les4675/CubeSatTimeCard/Documentation/Phase 1/Use Cases.pdf

Prompt:
Write at least one complete use case - divide up amongst team members so that each student completes a different one.

Rubric:

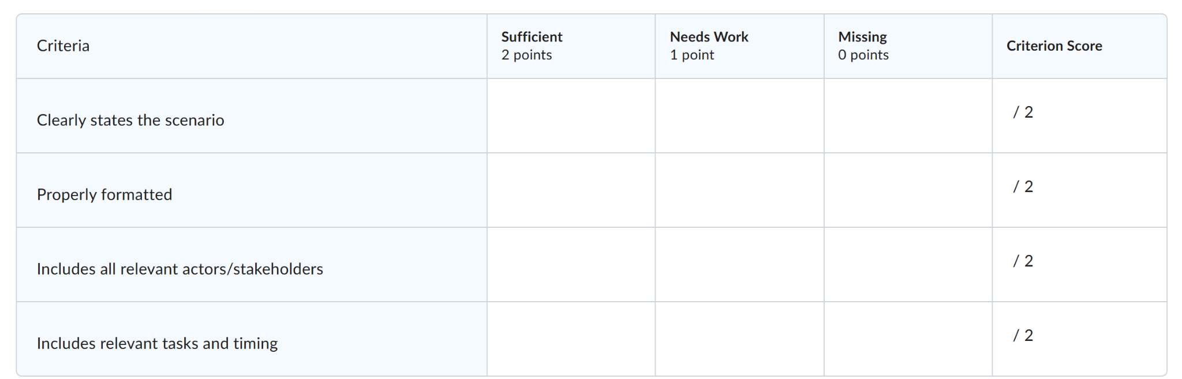
[picture p18: figure]

Use Cases:
1. Atomic clock used to track takeoff of Blue Origin rocket with astronauts
2. Atomic clock used to calculate the position and trajectory of a SpaceX rocket in deep space
3. Atomic clock used for error checking diagnostics of the cubesat
4. Atomic clock used to record precise timestamp for data collection
5. Atomic clock used to allow for proper communication between different channels (baud rate)
6. Atomic clock used for experiments that require precise timing
7. Atomic clock used for time-based encryption between cubesat and ground communications.

Use Case #1:

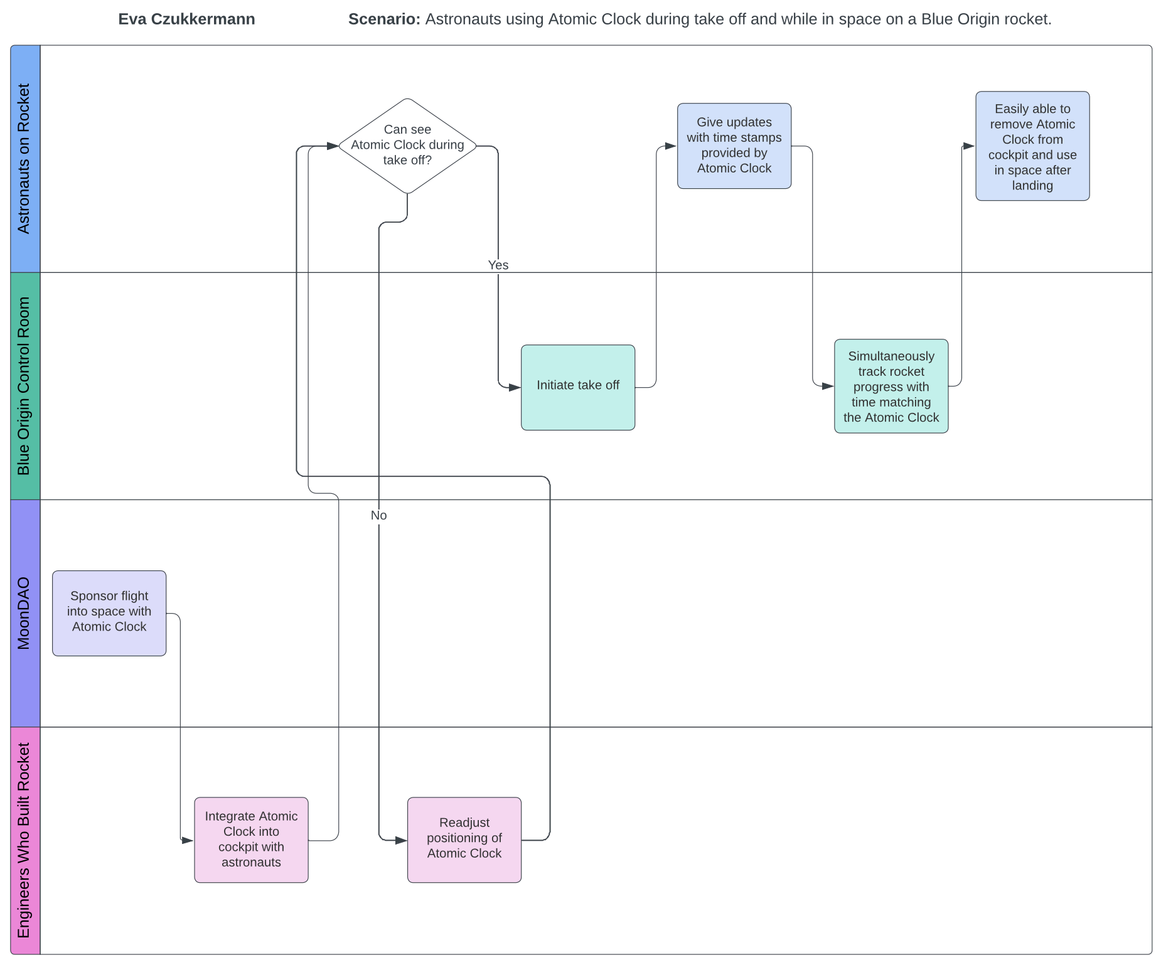
[picture p19: figure]

Use Case #2

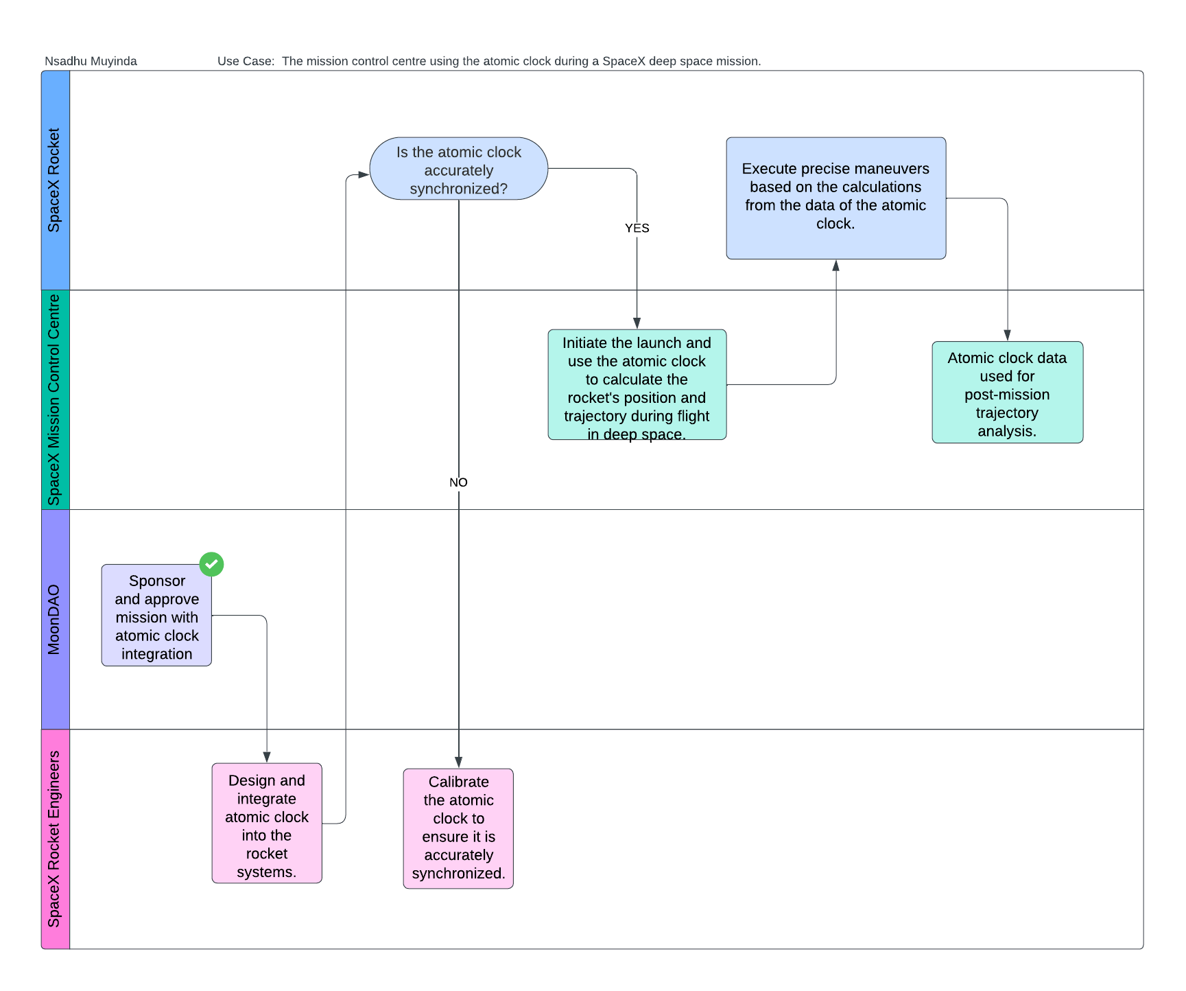
[picture p20: figure]

Use Case 3:

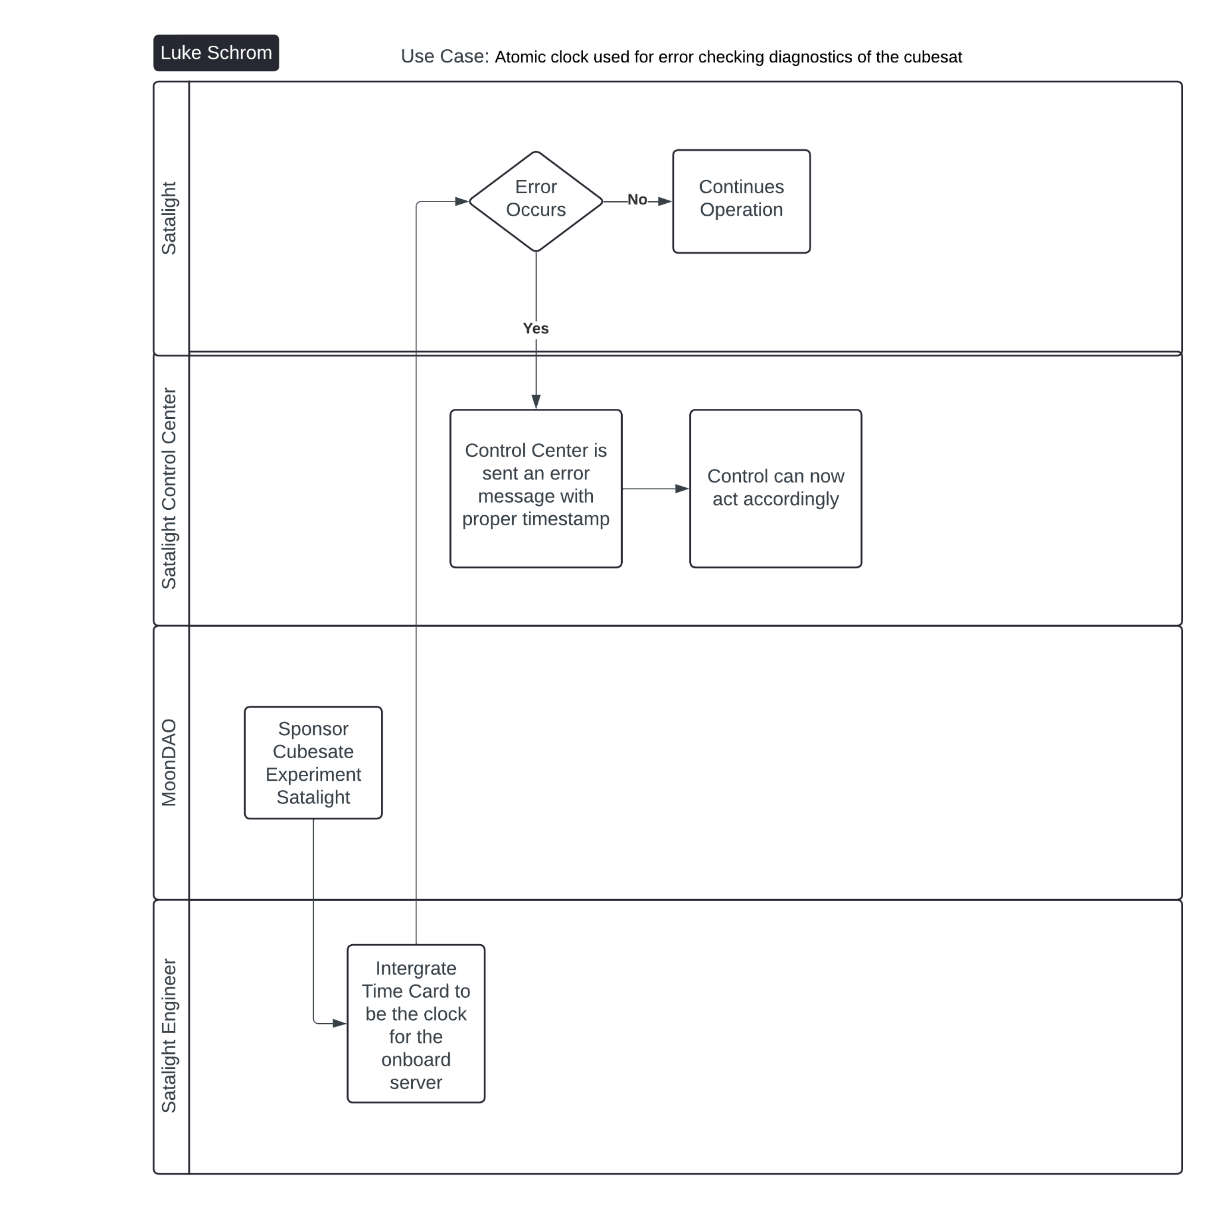
[picture p21: figure]

Use Case 4:

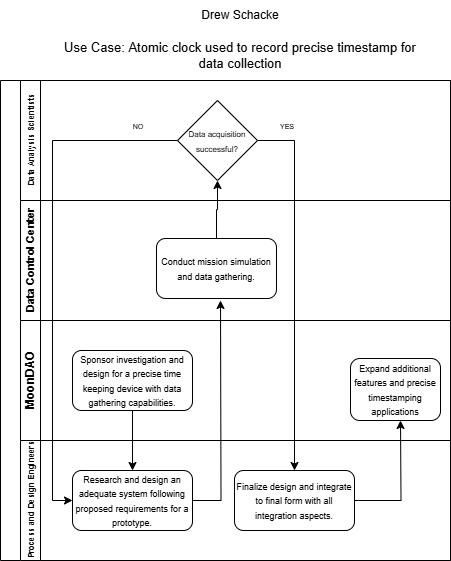
[picture p22: figure]

U

s

e

C

a

s

e

7: A

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
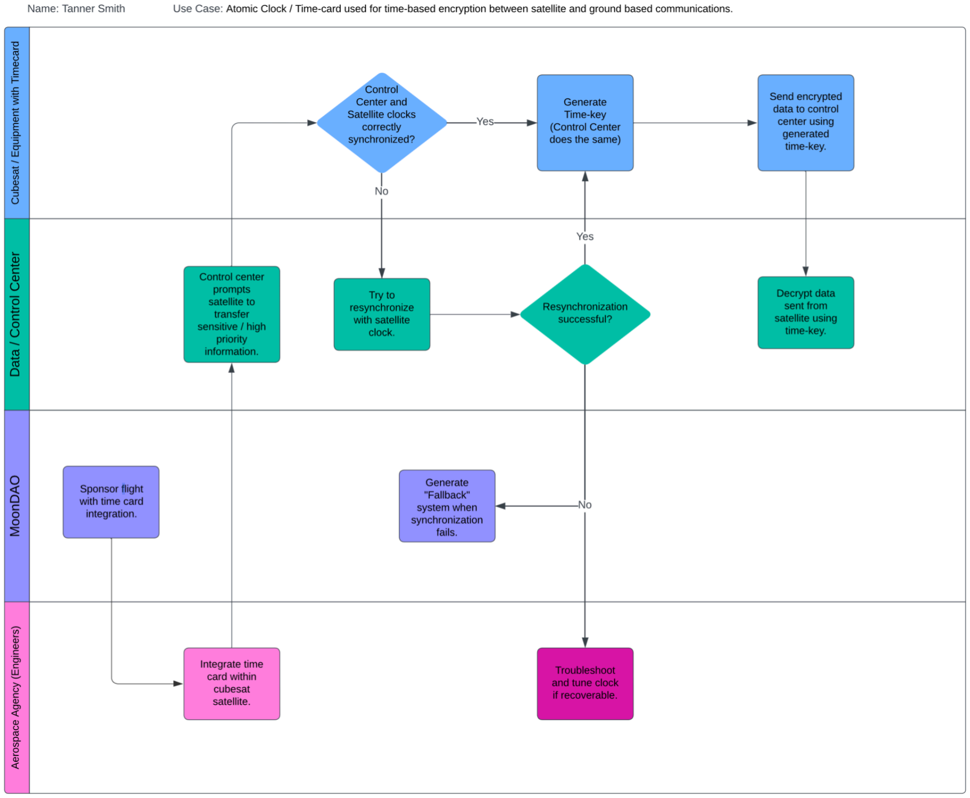
[picture p23: figure]
