les4675/CubeSatTimeCard/Documentation/Phase 4/GNSS Raspberry Pi Server.pdf

Goal: Have a raspberry pi emulate a server that takes in a signal from a GNSS receiver and then relays that information to the time card.
Required materials:
Raspberry Pi: ie pi 5
Receiver:
https://www.digikey.com/en/products/detail/sparkfun-electronics/GPS-18037/16719314

Antenna: https://www.digikey.com/en/products/detail/sparkfun-electronics/GPS-14986/9682235

https://lucid.app/lucidchart/01e8cf91-477b-4eed-92a1-fcaabd95895d/edit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 (https://lucid.app/lucidchart/01e8cf91-477b-4eed-92a1-fcaabd95895d/edit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) Galileo 1575.42 MHz
https://novatel.com/support/known-solutions/gnss-frequencies-and-signals


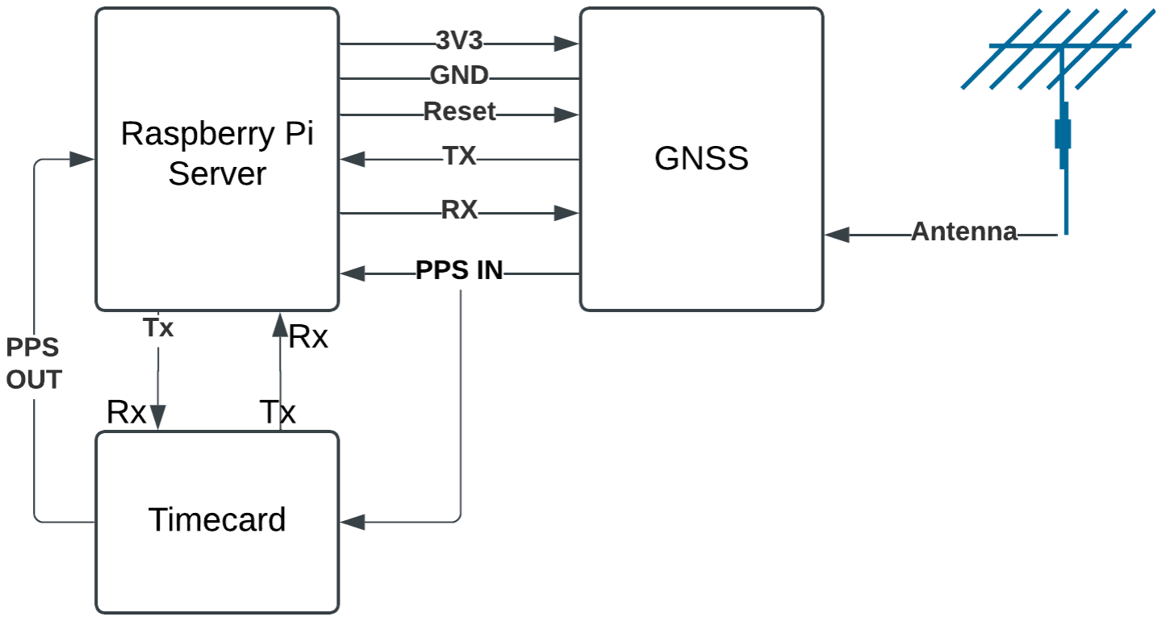
[picture p24: figure]

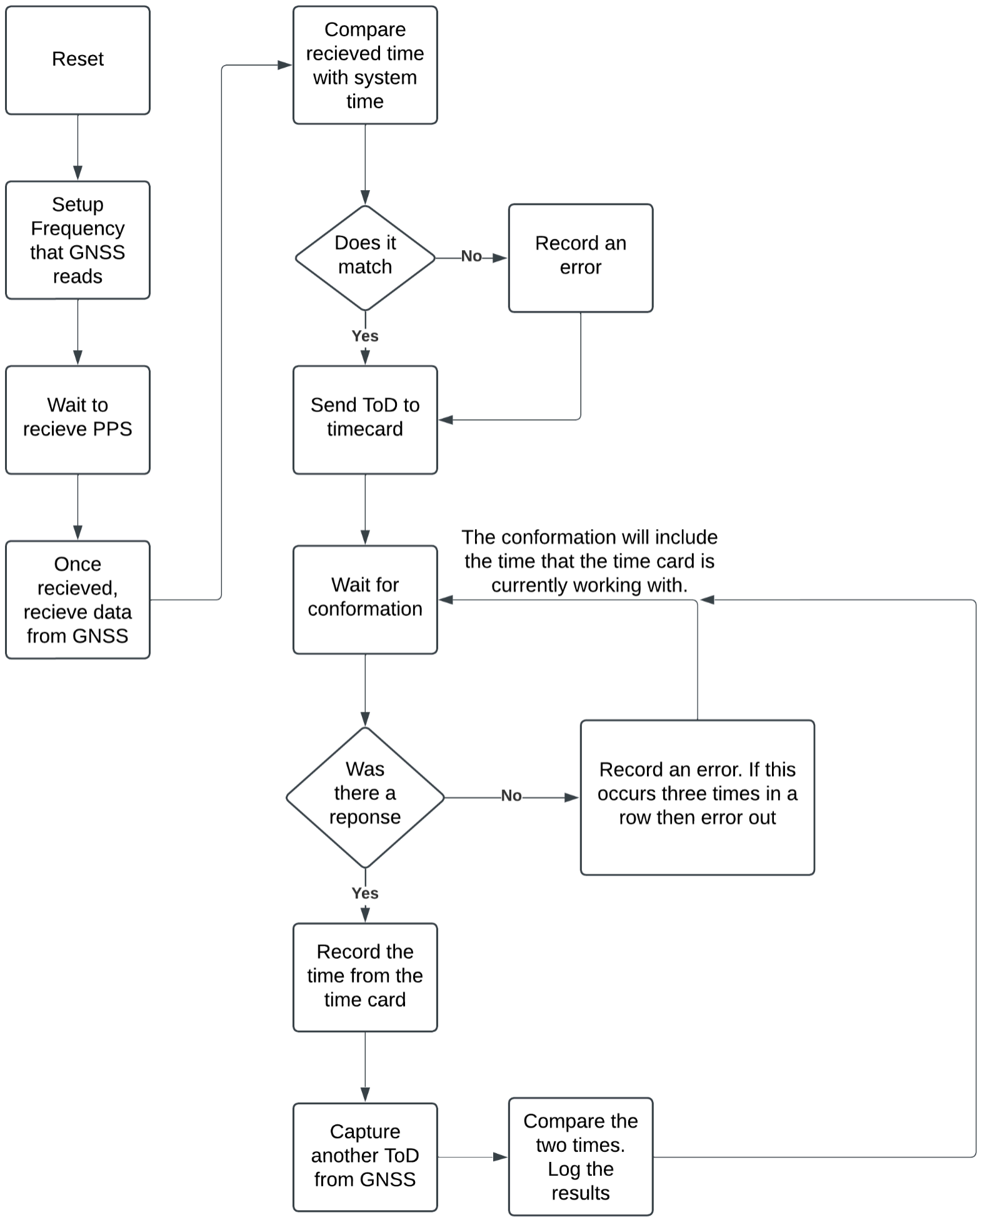
[picture p25: figure]
