les4675/CubeSatTimeCard/Documentation/Phase 3/Copy of Preliminary Detailed Design Phase Summary Report_Reference.docx.pdf

22257: Space Time Card

## Preliminary Detailed Design: Phase-End Summary

This document should continue to document your journey through MSD, so include work-in-progress as well as latest results – this document can be edited live online. Any time you post a snapshot of a document for a phase review, be sure you have a live document to back it up. Your file repository should still contain original editable files, not just .pdf files.

Use the Phase 3 folder to store information supporting this document. Some templates are available in this folder for your use.

Remove all template text from this page prior to your Week 10/11 Preliminary Detailed Level Design Review.

Individual and Team Vision for Preliminary Detailed Design Phase [Tanner]
- What did your team plan to do during this phase?
- What did your team actually accomplish during this phase?
- Since this phase will require students to do more independent work, your team should also capture a summary of key tasks completed, and who was responsible.

**Team plan for this phase:
We planned to start preliminary prototyping in order to prove functionality of our proposed solution that we presented previously. This includes revising component selections, development of a BOM, proposing development kits, testbenches, and ordering long lead time items.

** Accomplished during this phase:
We started producing the preliminary BOM, researching the functionality of the timecard through MATLAB, researching hold over drift characteristics of proposed CSAC and inserting other clocks, as well as inserting ordered items here.

Feasibility: Analysis, Simulations [Team]
Goals
- Justify that the design decisions you are making will result in an acceptable solution.

Instructions
1. Complete various analysis and simulation exercises, especially of critical subsystems. This could include ballpark estimates, and first order analysis.
2. Identify system "transfer function" based inputs, outputs, and key design parameters. This can be done via theoretical analysis or empirical prototyping. It's often helpful to work with multiple members to make sure each subsystem is accurate.
3. Using all of your analyses and models, determine values of all quantitative design parameters. These could be specific values and/or acceptable ranges.

Revised August 2024

4. Confirm that the selected concepts and design plans will be able to achieve the desired performance of your system. Also anticipate any potential failure modes associated with your chosen concepts.

Required Artifacts
- Document listing your quantitative Design Parameters, including quantitative targets and acceptable tolerances.
- Evidence of your feasibility work, including write ups of any theoretical analysis, and/or photos and videos of your simulations
- Summarize what you learned for each feasibility activity, and what decisions were made as a result.

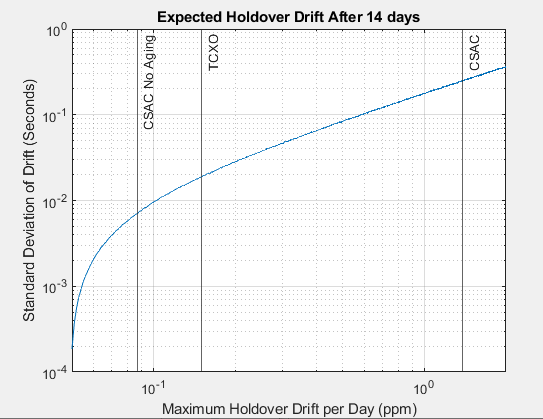
[picture p33: figure]
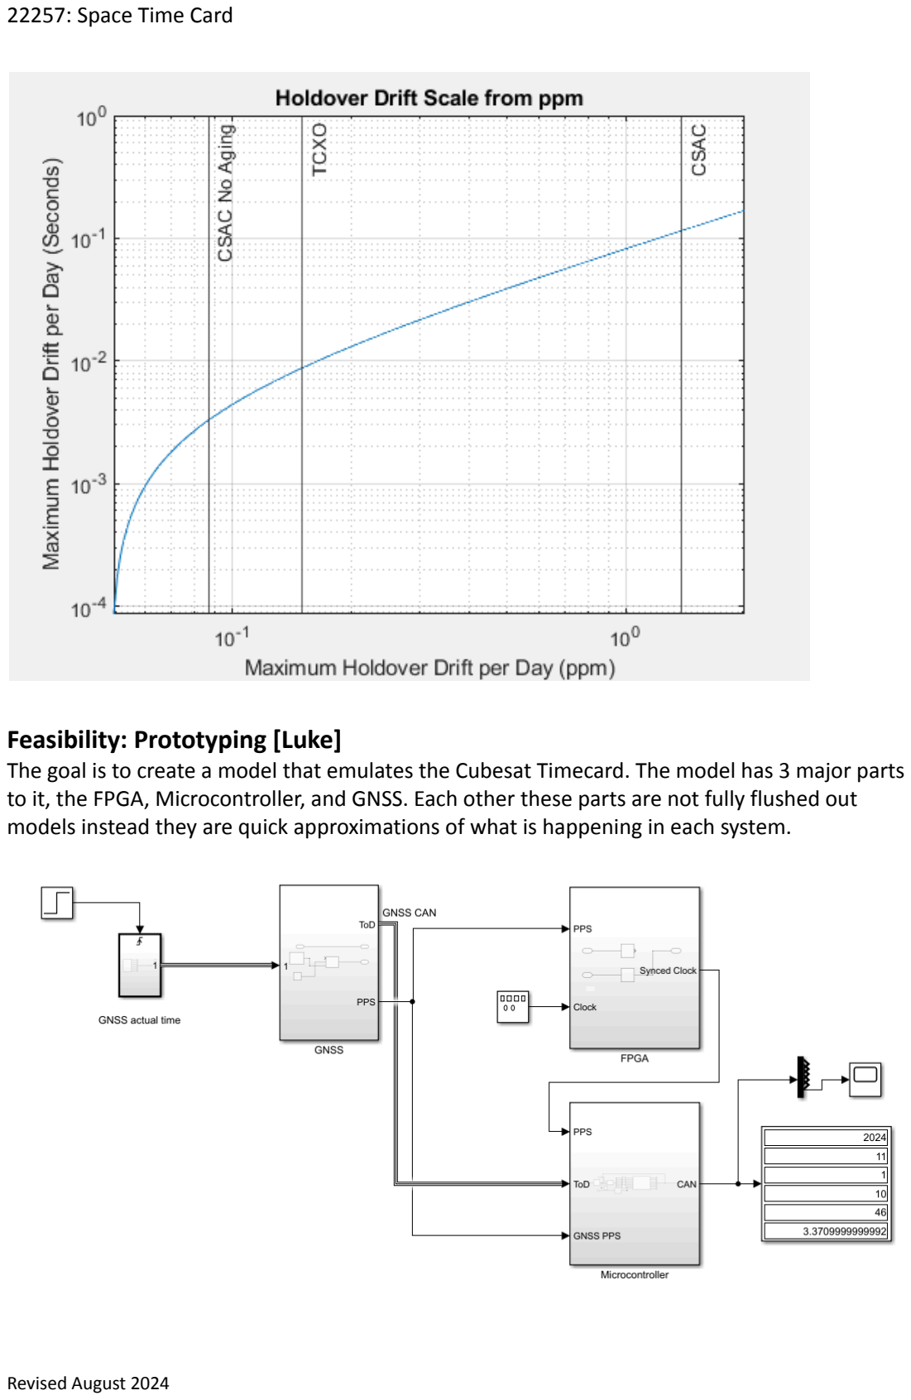
[picture p34: page 3]

Feasibility: Prototyping [Luke]
The goal is to create a model that emulates the Cubesat Timecard. The model has 3 major parts to it, the FPGA, Microcontroller, and GNSS. Each other these parts are not fully flushed out models instead they are quick approximations of what is happening in each system.

The model takes a GNSS input signal, this signal has two pieces of information that is necessary for what the time card is trying to do. The Pulse per second (PPS), and Time of Day (ToD). The function on the right grabs the time of day that is currently happening. On the left is the PPS signal that is being received.

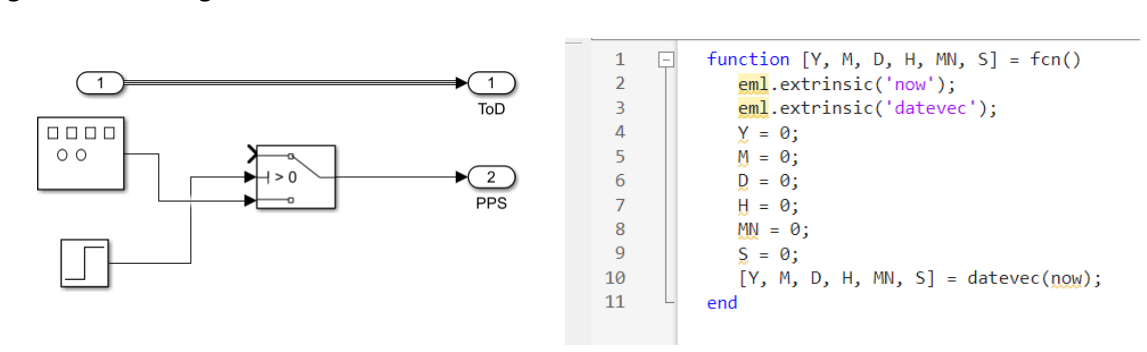
[picture p35: figure]

Once the signal is received then the PPS and ToD is used until disconnected. The FPGA then takes the PPS from the GNSS and then syncs the clock that is onboard with that PPS in a Digital Phase Lock Loop (DPLL). This is done with the following system on the FPGA.

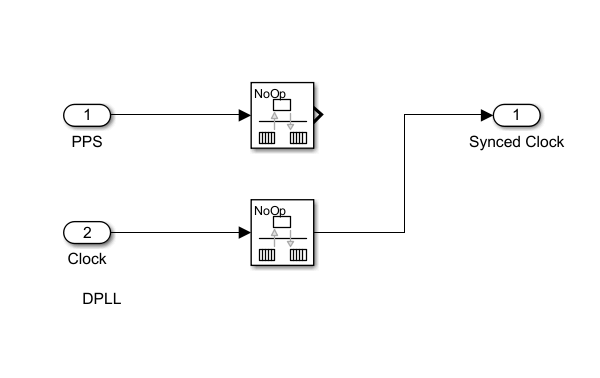
[picture p36: figure]

This synchronization clock is then used by the microcontroller to manage the time that is being kept. The signal can also be sent back out as an output for any other devices that want a PPS. The Microcontroller takes the ToD from the GNSS and saves it into memory, it will also take in a PPS to then manage the time, incrementing the seconds based on the rising edge of the PPS.

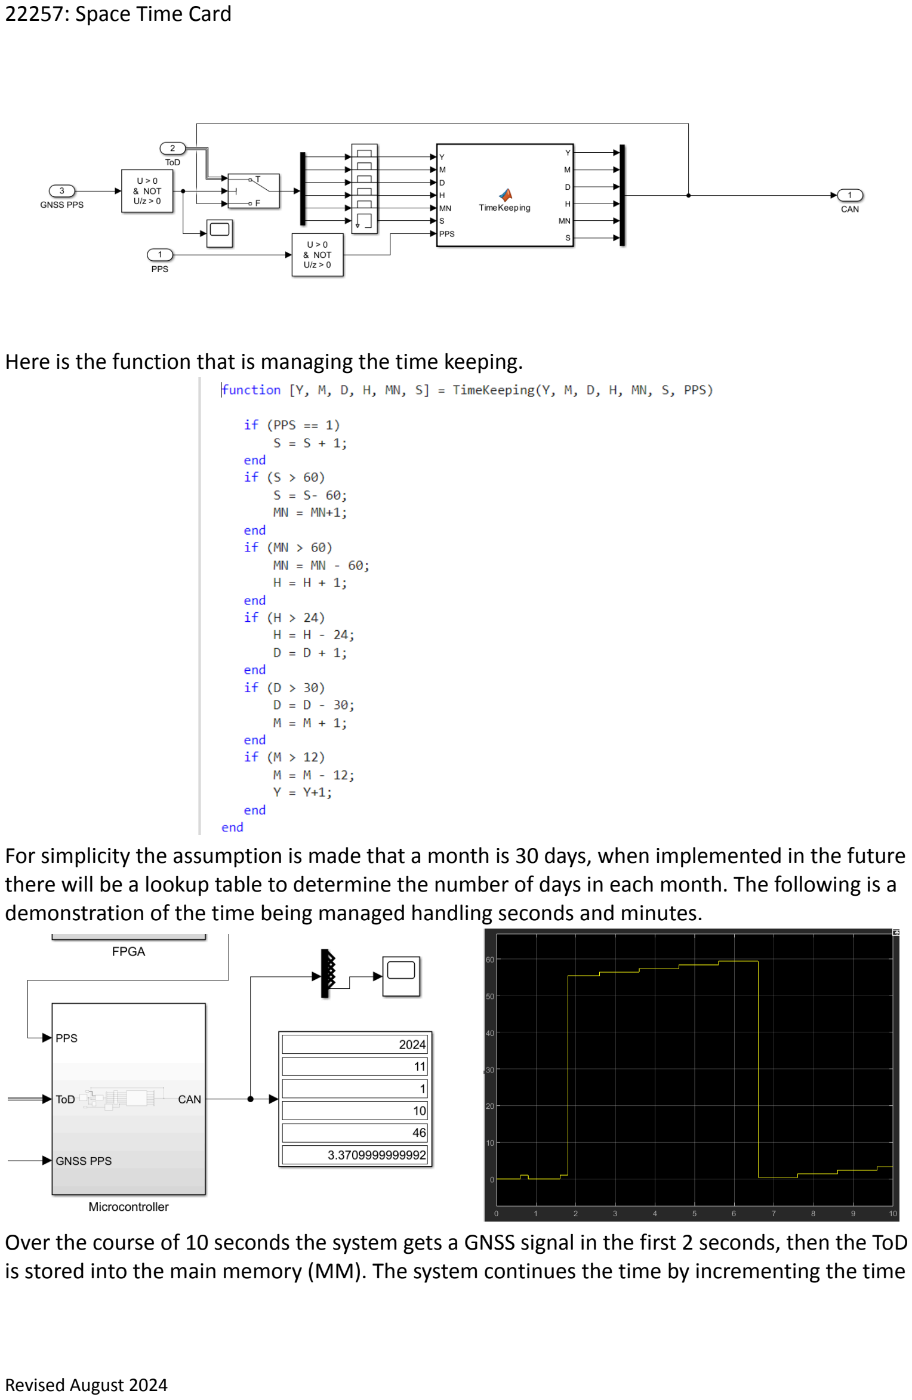
[picture p37: page 5]

Here is the function that is managing the time keeping.

For simplicity the assumption is made that a month is 30 days, when implemented in the future there will be a lookup table to determine the number of days in each month. The following is a demonstration of the time being managed handling seconds and minutes.

Over the course of 10 seconds the system gets a GNSS signal in the first 2 seconds, then the ToD is stored into the main memory (MM). The system continues the time by incrementing the time on each rising edge. When the minute threshold is reached it returns seconds to 0 and increments the minute.

Goals
- Quickly test the feasibility of competing options that would be time consuming to simulate
- Quickly evaluate a key but uncertain component or subsystem of your design before making design decisions dependent on that component or subsystem
- Begin fabricating or implementing critical elements of your final product or process

Instructions
1. Identify the functions that are uncertain, which can best be addressed by prototyping
2. Make use of MSD surplus, rapid prototyping, foam core, breadboard, cardboard, wireframe, etc.
3. Consider investing more time and budget into higher-fidelity prototypes
4. Consider purchasing high-risk components

Required Artifacts
- In this document, include
- what you wanted to learn
- the limitations of the prototype
- summarize what you learned
- explain the decision made as a result
- Photos can be embedded in this document. Videos can be posted in EduSourced.

Drawing, Schematics, Diagrams [Tanner & Nsadhu]
Goals
- Complete a significant portion of the detailed design of your system.

Instructions
1. Define all mechanics of subsystems, including geometries, software design, interfaces, and fabrication instructions for unique parts.
2. Call out all purchased parts
3. Adhere to all required design standards.
4. As with your feasibility analysis, anticipate potential failure modes with your chosen designs.

Required Artifacts
- Complete hierarchy of design files, from system level down to components. This may include (but is not limited to):
- CAD models/sketches
- Software design, including specific coding requirements
- Electrical diagrams
- Note that your file archive needs to include actual design files, in addition to manufacturing files (e.g., CAD solid model files, plus manufacturing files like drawing files and/or STL files)
- List of relevant standards, and how your team is satisfying them

High Level System diagram:

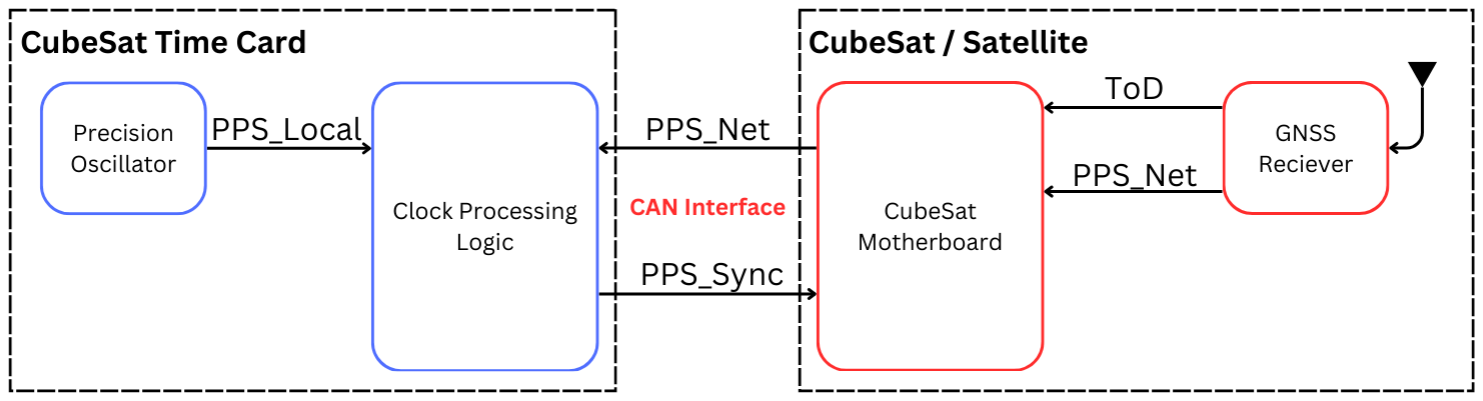
[picture p38: figure]

Link to Edit:
https://www.canva.com/design/DAGU9_wbepU/g5HjgDUYyRt2cYX66BF65w/edit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 (https://www.canva.com/design/DAGU9_wbepU/g5HjgDUYyRt2cYX66BF65w/edit) Public View Link:
https://www.canva.com/design/DAGU9_wbepU/3GgiWLj0Og3cwYhZnoNWGQ/view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 (https://www.canva.com/design/DAGU9_wbepU/3GgiWLj0Og3cwYhZnoNWGQ/view)

Phase Detector:
Takes two PPS inputs, produces output that is proportional to the phase difference between the two input signals. Traditionally output a pulse width proportional to the phase difference.

Loop Filter:
Reduces noise, improves stability, shapes the transient response, and controls the phase margin. Outputs a VCO control signal, used to tune / adjust the characteristics of the local TCXO / Atomic clock.

SteeringProcess:
Run through this on 11/5/2024 with group… (Im a little confused on how this is implemented).

Divider:
Receives the LVCMOS signal produced from the TCXO / Atomic Clock. Reduces the frequency of the input by a specific ratio. This must be an accurate and precise process.

Phase Lock Loop [PLL]:
Often used for frequency synthesis, clock recovery, and motor controllers. The PLL receives two input signals, identified as the reference and feedback signals. In this case the feedback signal is represented by the locally produced PPS. Similarly, the reference signal is represented by the PPS produced from the GNSS. The difference in phase between the two input signals is extracted through the use of a phase detector. This difference is then fed into a loop filter that produces a correlated value to the phase difference. This in turn gives a variable that can be used to “tune” the local TCXO / Atomic clock, to be in phase with the external network GNSS produced PPS.

Bill of Material (BOM) [Drew (The purchaser)]

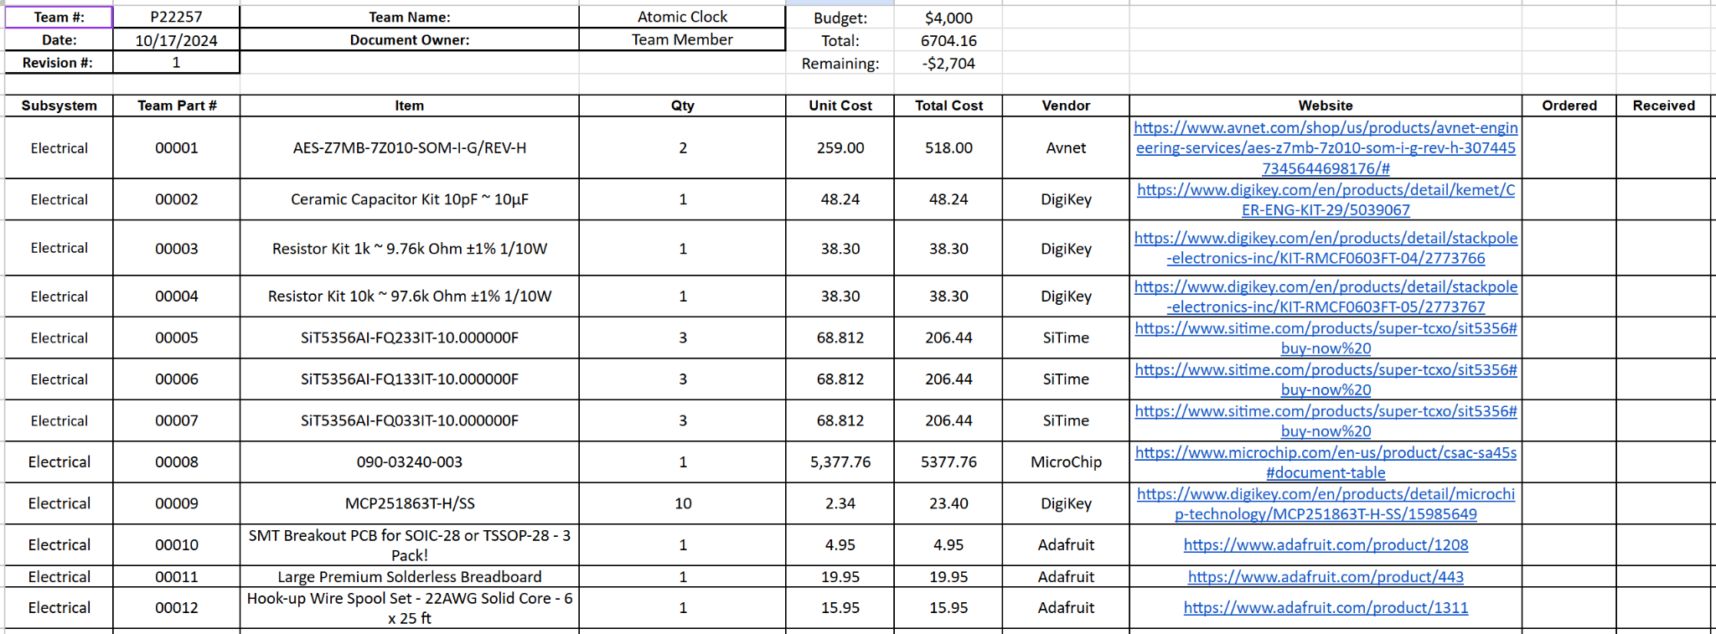
[picture p39: figure]

Required Artifacts
- Draft BOM available in EduSourced, with a snapshot/summary in this document.
- Brief summary of the team’s budget status: what assumptions have you made, are you projected to be within budget or not, are there any cost risks, etc?
- If the team is requesting additional budget, include rationale here

Test Plans [Ian & Eva]
Goals
- To create a set of test plans that will demonstrate objectively the degree to which the Engineering Requirements will be satisfied by the either component, subsystem, or system tests.
- To create a set of test plans that will enable you to objectively determine that your components or subsystems are functional and ready for system integration

Instructions
1. Complete test plans specifying the data to be collected, instrumentation to be used, testing procedures and personnel who will conduct the tests.
2. Tests to assess accuracy of feasibility models: Make plans and execute these tests throughout the second half of MSD I
3. Tests to verify that your final subsystems work: Make plans and execute these tests once you start your final prototyping, prior to system integration
4. Tests to verify that your final system satisfies the ERs your team and client agreed to: Generally, you will execute these tests once you start your final system integration
5. Note that tests to verify that you've met a system constraint or delivered a required feature may be fairly trivial. You don't need a detailed test plan to demonstrate that your prototype budget was <$500 or that your full system weighs less than 20 lb, for example. Discuss with your guide if you're not sure how much detail to include.
6. If your team's testing will involve human subjects, you must review the RIT Human Subjects Research Office "Protecting Human Subjects" page found here: https://www.rit.edu/research/hsro/ for details on securing approval for work with human subjects
7. Look at industry test standards (e.g., ASTM). The RIT library maintains an infoguide with links to standards databases found here: https://infoguides.rit.edu/standards , many of which provide industry-standard test procedures for a variety of components and systems. Cite these if used.

Required Artifacts
- Test Plans (use the “Requirements and Testing.xlsx” template), available in EduSourced. Include an updated version of the document in this phase folder, labeled by phase to distinguish it.
- In this document, include a table that summarizes the degree to which ERs are addressed by your test plans.
- If applicable, an Institute Review Board or Institute Biosafety Committee submission (allow at least 30 days for this to be reviewed - more time is ideal, since the IRB or IBC outcome may be a request for you to modify your proposed test protocol)

System Design and Flowcharts/System Block Diagram [Tanner/Drew]
Goals
- Provide a high-level view of elements involved in building and operating your system.

Instructions
1. Continuously update the diagrams from your systems level design documentation.

Required Artifacts
- A snapshot of your current system design diagrams
- A link to the live version of your system diagrams, if applicable.
- A brief summary of the current status of the design, based on work done during this phase. Which blocks/functions are complete, which are nearly complete, which still need work?

This is the same as the block diagrams above. I believe the diagrams belong here not above. As above should be more technical such as pinouts and

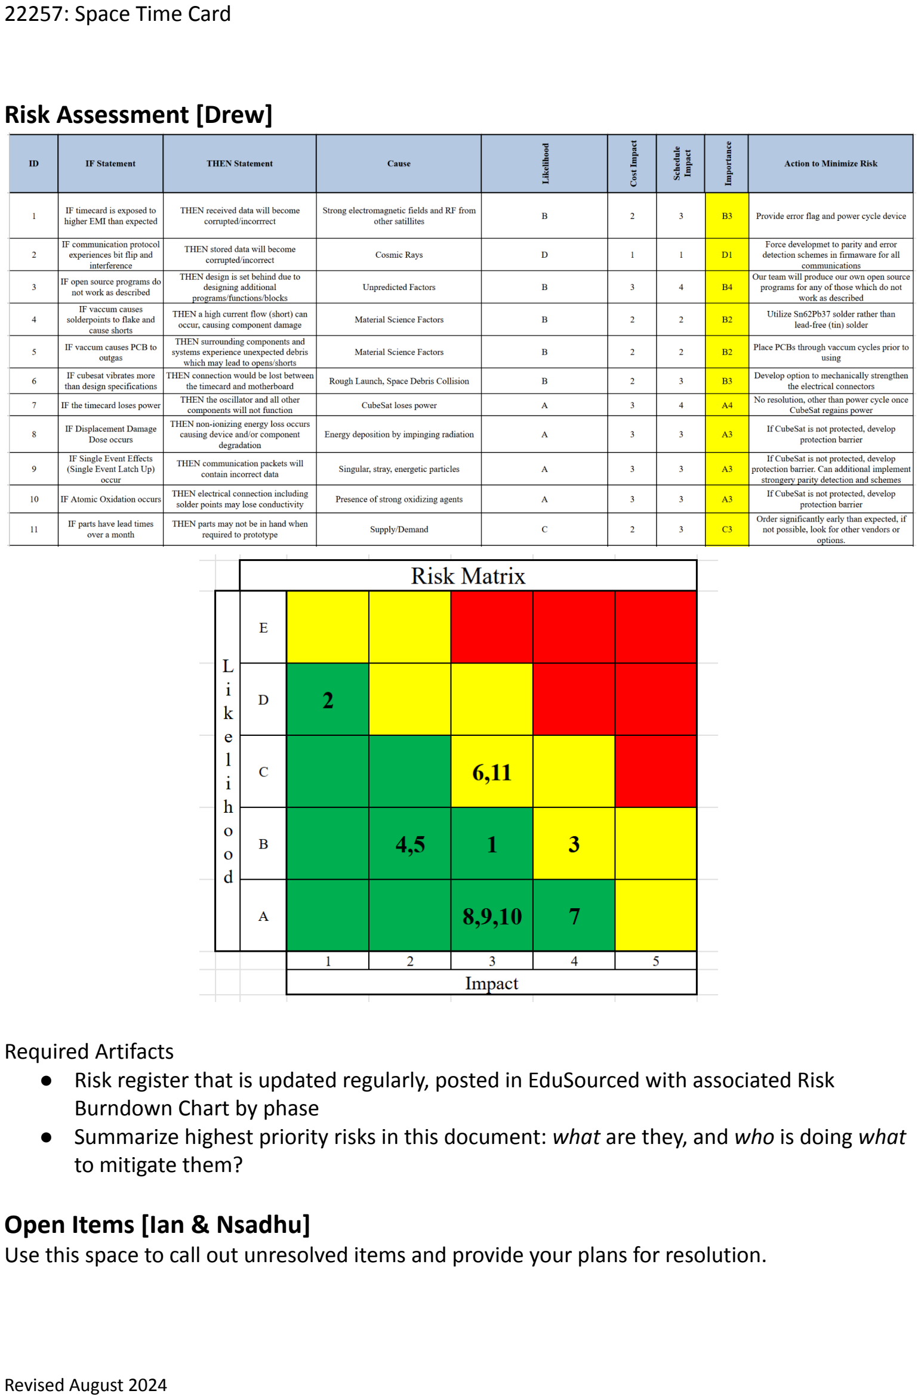
[picture p40: page 11]

Risk Assessment [Drew]

Required Artifacts
- Risk register that is updated regularly, posted in EduSourced with associated Risk Burndown Chart by phase
- Summarize highest priority risks in this document: what are they, and who is doing what to mitigate them?

Open Items [Ian & Nsadhu]
Use this space to call out unresolved items and provide your plans for resolution.

Project Management [Tanner & Eva]
Developed a Task-based Project Management list using Trello. Each card should include:
- Description of Task to be completed by next group meeting by individual team members
- Task Owner identified
- Date Task issued
- At minimum there should be 3 column from L to R:
- Planned Tasks
- Tasks in Process
- Completed Tasks
The Trello board should be linked to this document along with a snapshot Mid-Phase Sprint/Scrum Review with Guide based on Trello board Sprint-end Retrospective - Answer the following questions:
- What went well?
- What could be improved?
- What do we commit to improving in the next Sprint?

Link to Trello:
https://trello.com/invite/b/671a78edf4f62e22545281ae/ATTI2b4091480a6eaea83d203fbbd5bb69d9F87302C9/atomic-clock (https://trello.com/invite/b/671a78edf4f62e22545281ae/ATTI2b4091480a6eaea83d203fbbd5bb69d9F87302C9/atomic-clock)

Design Review Materials [Eva]
Be sure to update the following in your Phase 3 folder:
- Pre-read with agenda and presenters listed
- Presentation and/or handouts
- Notes from review, including action Items
- Supporting documentation for your client.
Share this page and relevant supporting documents with your client in preparation for the review. This will ensure that they know what you will be presenting and how to view all of your work. Draft work you’ve been keeping in a Google drive should be copied to this phase folder in EduSourced as a snapshot in time of your progress.

Pre-read: Summary Report (https://docs.google.com/document/d/1VkYq_ritw-VHQkLwa2P_NB2luzrZDebQ/edit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) and Presentation (https://docs.google.com/presentation/d/1okdFfzSBusoWpsRbfHt5OSLMaxlNplr-AVOWNgsIxog/edit?usp=sharing)
- Agenda
- Discuss progress made in the Preliminary Detailed Design Phase
- Presenters
- Eva Czukkermann, Ian Dolfi, Nsadhu Muyinda, Drew Schacke, Luke Schrom, Tanner Smith
Notes from Review: Design Review Notes (https://docs.google.com/document/d/1UgBdK8pxTM69vPbYON1KdWaR0ZGtFmMD/edit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) Documentation:
Presentation (https://docs.google.com/presentation/d/1okdFfzSBusoWpsRbfHt5OSLMaxlNplr-AVOWNgsIxog/edit?usp=sharing)
Block Diagrams
Trello Board (https://trello.com/invite/b/671a78edf4f62e22545281ae/ATTI2b4091480a6eaea83d203fbbd5bb69d9F87302C9/atomic-clock)
Risk Assessment (https://docs.google.com/spreadsheets/d/1sEJPviIE8MG_mG6ImOmllqRdP-IQmyIl/edit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)
Gantt Chart (https://docs.google.com/spreadsheets/d/175Oc5RSNjGTzMNT9uip6kQZqAMXzPgB3WDZRYHYPpP4/edit?usp=sharing)

Requirements and Testing (https://docs.google.com/spreadsheets/d/1AyazgeLOqcwIVji6cZBRRxJEtnvjj9Z5/edit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)
Bill of Materials (https://docs.google.com/spreadsheets/d/1MDOcxyusa8s8zq_j0ynEQH-B78koKIm4/edit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)

Goals for next phase [Tanner]
As a team, where do you want to be at your next review? Visualize for the customer what the end state for the next phase will be. What are your goals for the next phase?

Individual phase plans (what did I plan to do, what did I actually do, what did I learn, what do I plan to do next, and what blockers might I have) are due to myCourses.

Required Artifacts
- Include a list of planned tasks, by team member, for the upcoming phase. A snapshot of your overall project plan (Gantt chart) should be linked in this document, and must be included in your EduSourced Phase folder
- Phase-end Retrospective - Answer the following questions:
- What went well?
- What could be improved?
- What do we commit to improving in the next Phase?
