les4675/CubeSatTimeCard/Documentation/Phase 1/Vibe Figures (1).pdf

How the vibe figures were determined:

Found in MIL-STD-810H METHOD 514.8, this table shows that the missile platform most closely aligns with the launch vehicle the time card would be on (a rocket). It references Test I and IV for missiles.

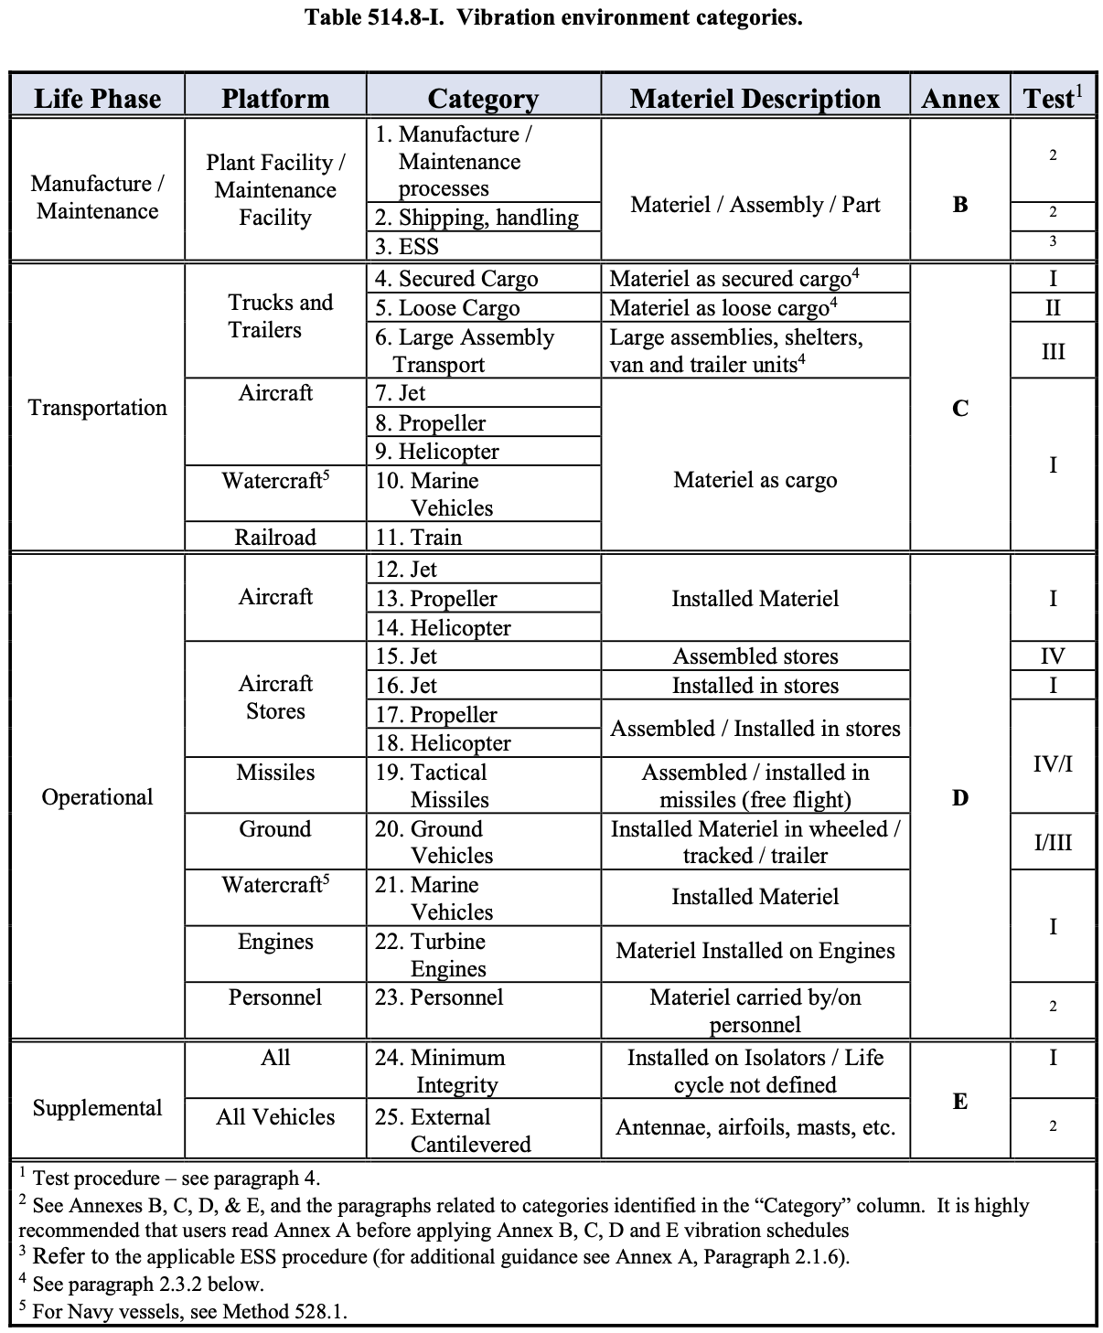
[picture p41: figure]

The following section describes the differences among the procedures. Note that Procedure IV states that Procedure I should not be used for free flight phases.

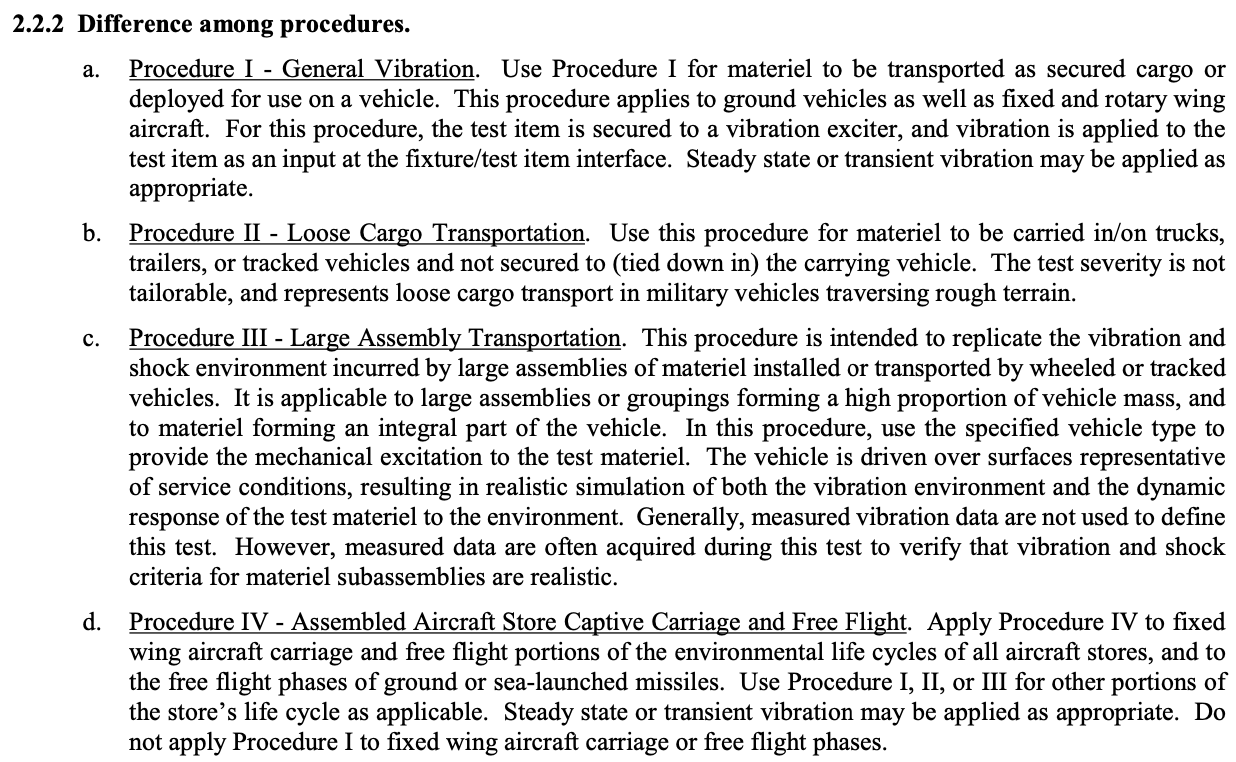
[picture p42: figure]
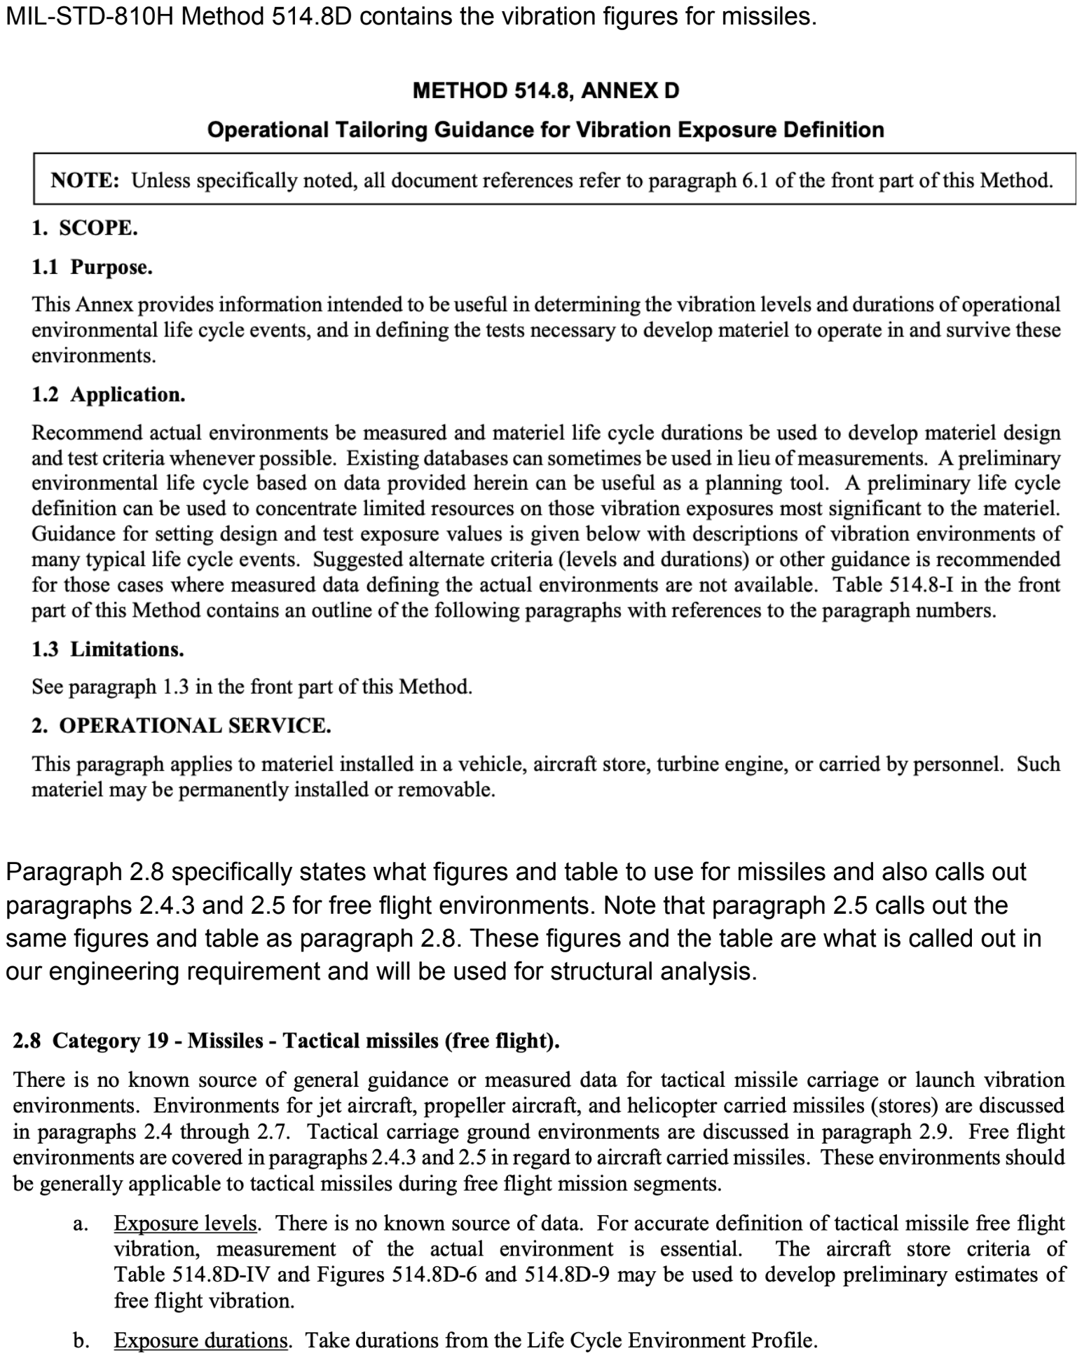
[picture p43: page 3]

MIL-STD-810H Method 514.8D contains the vibration figures for missiles.

Paragraph 2.8 specifically states what figures and table to use for missiles and also calls out paragraphs 2.4.3 and 2.5 for free flight environments. Note that paragraph 2.5 calls out the same figures and table as paragraph 2.8. These figures and the table are what is called out in our engineering requirement and will be used for structural analysis.

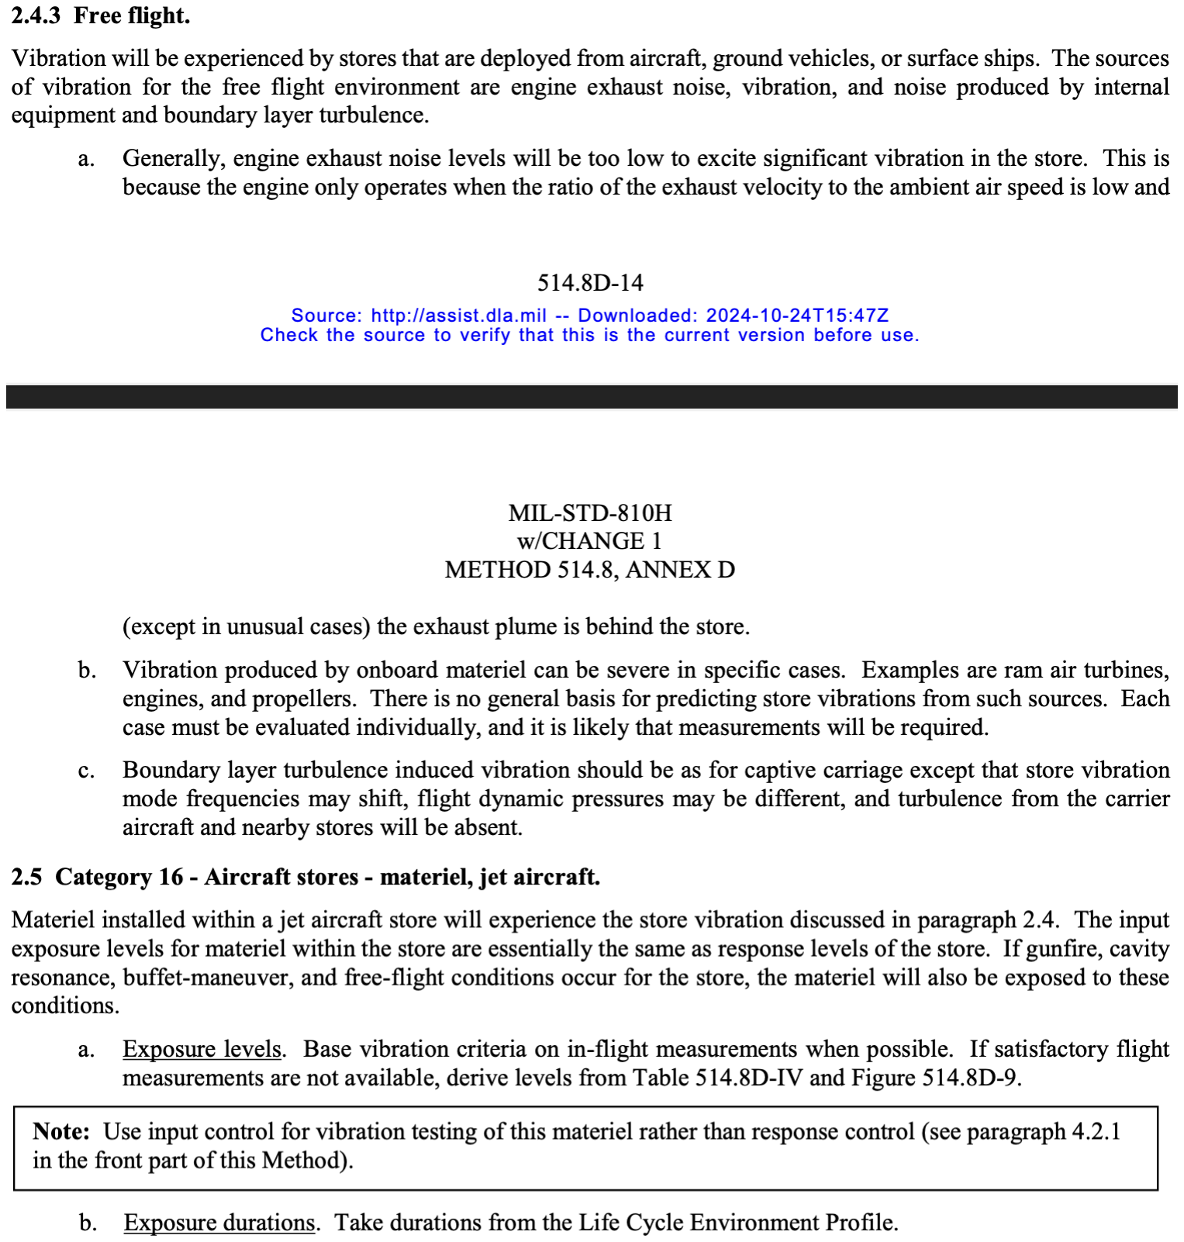
[picture p44: page 4]
