les4675/CubeSatTimeCard/Documentation/Phase 2/Functional Decomposition.pdf

Submit a single image/pdf file of your function tree and transformation diagram. Make sure each function is written using the verb-noun construct, and identify the functions where you feel there is the most opportunity for creative brainstorming.

Credit will be given to work that is legible, so handwritten documents must be neatly done in order to earn credit, and screenshots must be of sufficient resolution to read the text.

Luke Schrom:

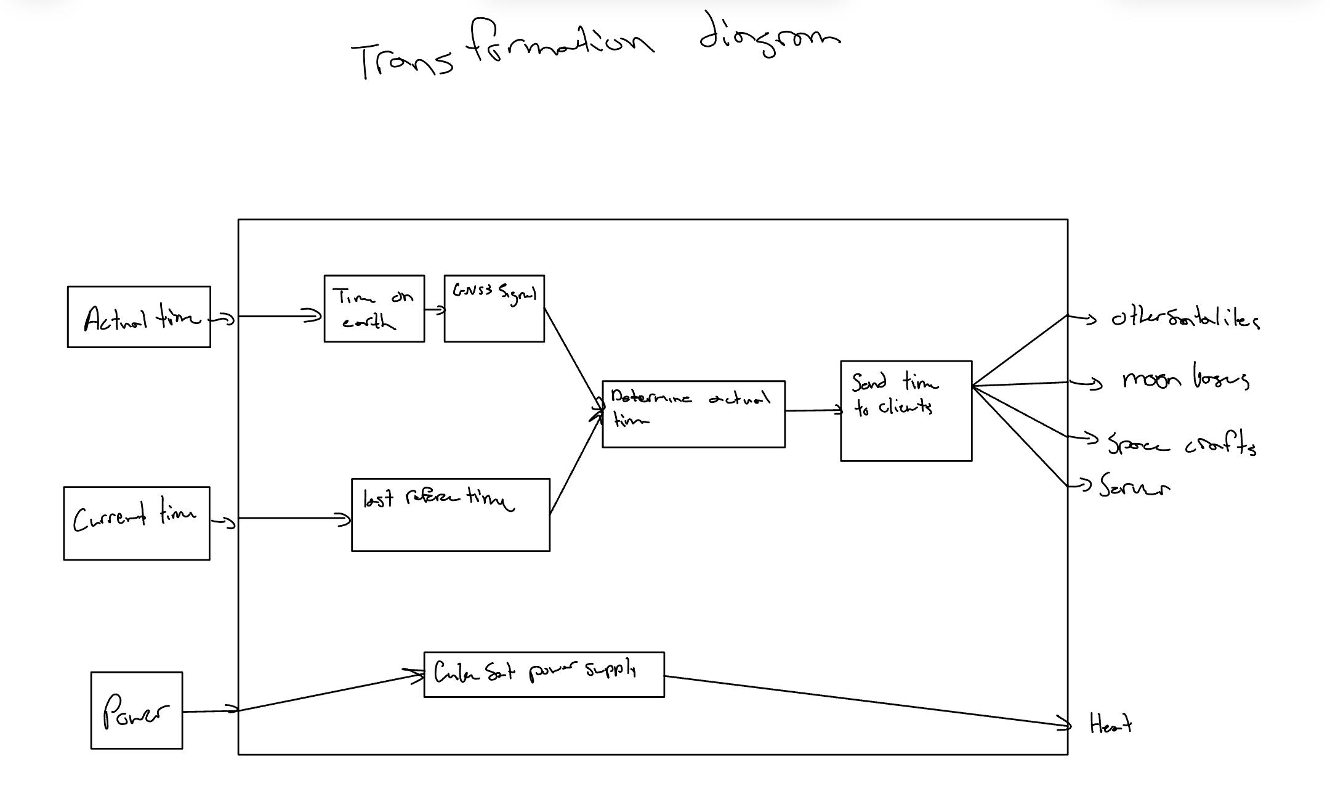
[picture p45: figure]
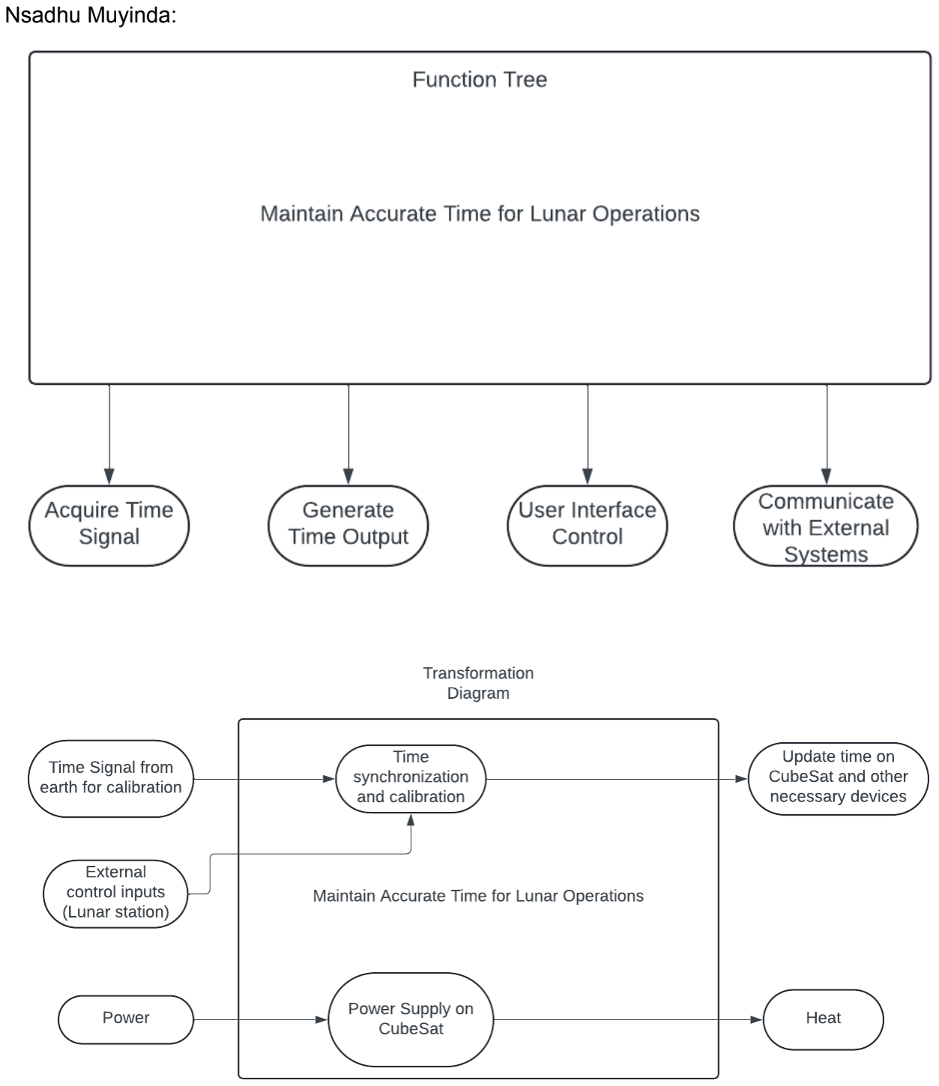
[picture p46: page 2]

Nsadhu Muyinda:
