les4675/CubeSatTimeCard/High Level Model/UsefulFigures/ADEV-BestModel.jpg

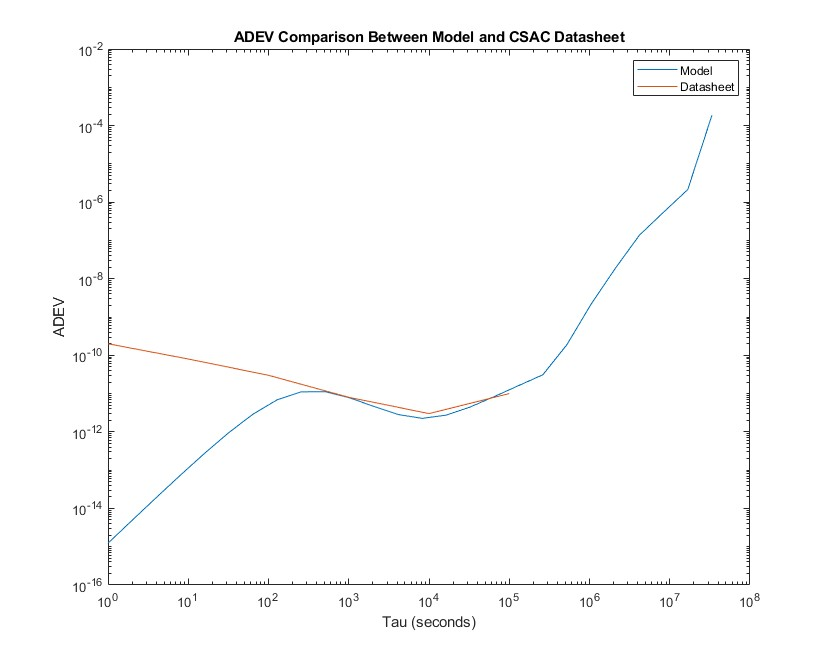
High Level Model/UsefulFigures/ADEV-BestModel.jpg
