les4675/CubeSatTimeCard/High Level Model/UsefulFigures/OscillatorNoiseResponsefig.jpg

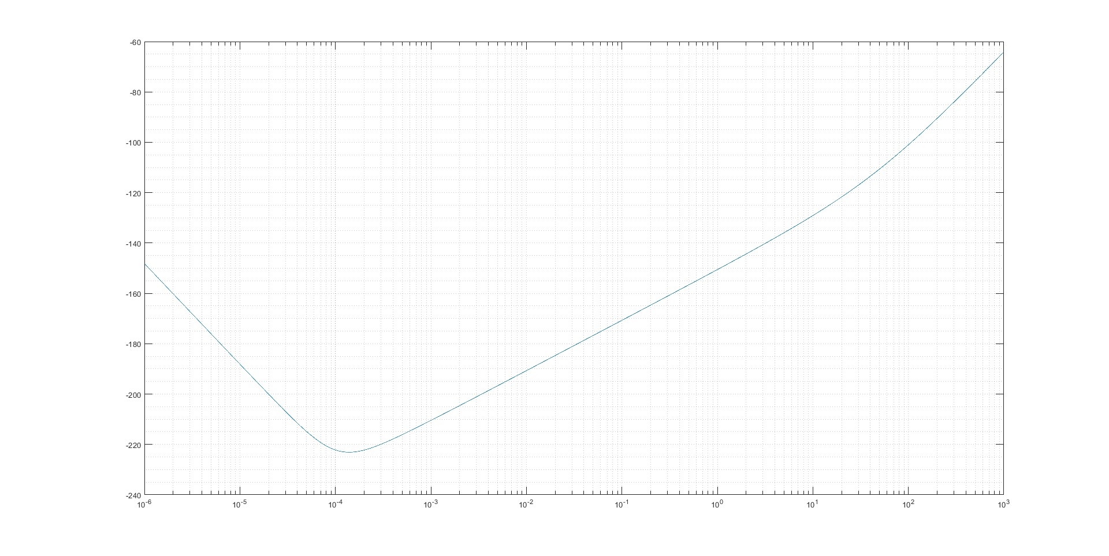
High Level Model/UsefulFigures/OscillatorNoiseResponsefig.jpg
