les4675/CubeSatTimeCard/Phase Detector/TestData/HoldoverTest_105Hrs_03-10-2025.pdf

Import Data

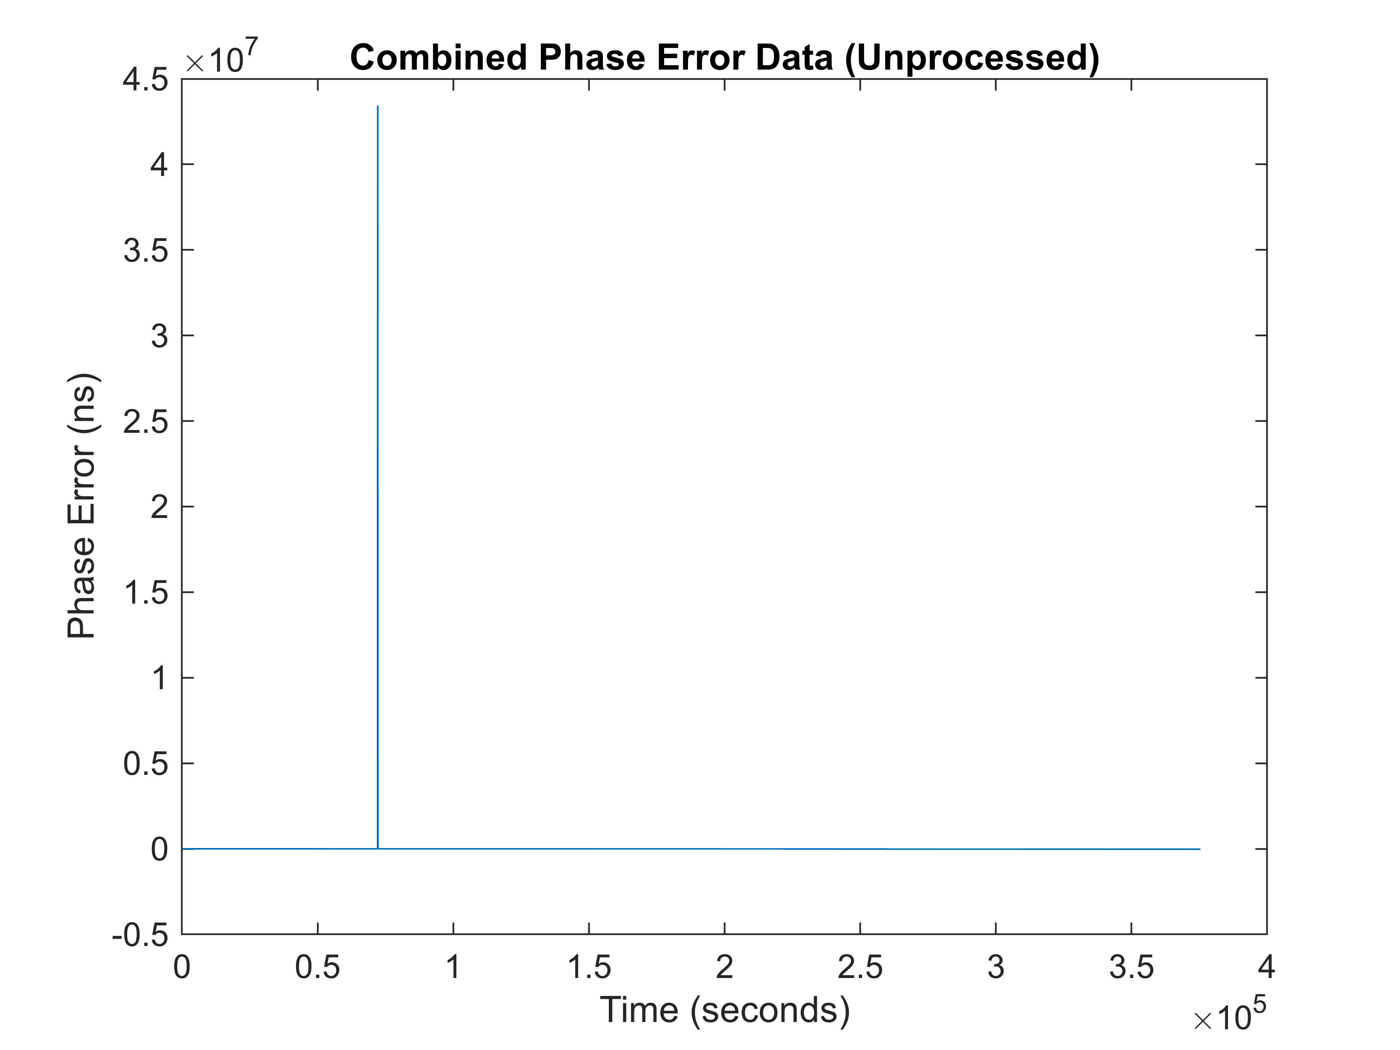
[picture p49: figure]

Remove Data Glitches (Outliers)

Process data from the long-term lower-precision section of the test

Warning: Polynomial is badly conditioned. Add points with distinct X values, reduce the degree of the polynomial, or try centering and scaling as described in HELP POLYFIT.

Warning: Polynomial is badly conditioned. Add points with distinct X values, reduce the degree of the polynomial, or try centering and scaling as described in HELP POLYFIT.

The moving average processsing will be used. For temperature specifically, a lowpass filter should be applied for more accuracy (to simulate thermal capacitance of the CSAC)

Calculate frequency error from phase error

Display data to be exported

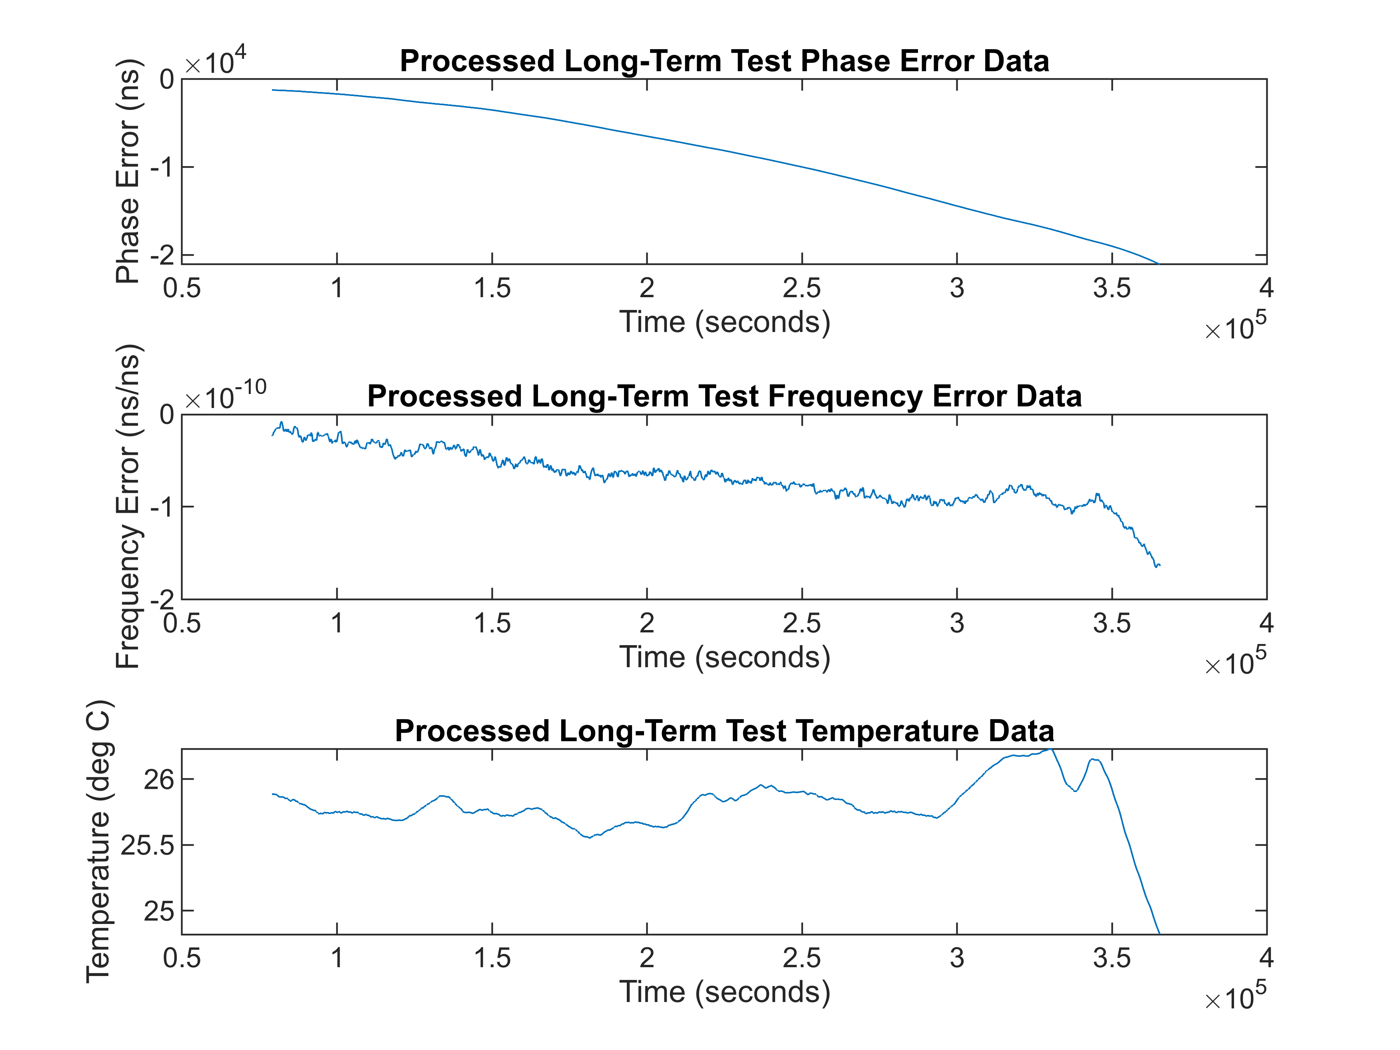
[picture p50: figure]
