les4675/CubeSatTimeCard/Phase Detector/TestData/ProcessedData_72hrs_ExcelFitting.xlsx

Time (Seconds) | Phase Error (ns) | Measured Frequency Error (ns/ns) | Temperature (deg C) | Prediction Curve | Residual | Residual Squared | Aging Factor (1/s) | Temperature Dependence (1/degC) | Offset | Param1 | Param2
79104 | 1264.654231 | 1.46e-11 | 25.9025 | 1.46e-11 | 0 | 0 | 3.697640162e-16 | -3.301260618e-11 | 1.46e-11 | 3.697640162 | 33.01260618
79114 | 1264.799979 | 1.46e-11 | 25.90208 | 1.461756293e-11 | -1.756293476e-14 | 3.084566773e-28
79124 | 1264.945926 | 1.46e-11 | 25.90164 | 1.463578612e-11 | -3.578612164e-14 | 1.280646502e-27 | Variance: | 1.098867768e-19
79134 | 1265.092071 | 1.46e-11 | 25.9013 | 1.465070805e-11 | -5.07080479e-14 | 2.571306122e-27
79144 | 1265.238412 | 1.46e-11 | 25.90084 | 1.466959149e-11 | -6.959148691e-14 | 4.84297505e-27
79154 | 1265.384952 | 1.47e-11 | 25.9004 | 1.468781467e-11 | 1.218532621e-14 | 1.484821749e-28
79164 | 1265.531688 | 1.47e-11 | 25.8999 | 1.470801862e-11 | -8.018617042e-15 | 6.429821926e-29
79174 | 1265.678619 | 1.47e-11 | 25.89946 | 1.47262418e-11 | -2.624180392e-14 | 6.886322731e-28
79184 | 1265.825748 | 1.47e-11 | 25.8991 | 1.474182398e-11 | -4.182398231e-14 | 1.749245496e-27
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
