les4675/CubeSatTimeCard/Phase Detector/TestData/ProcessedData_105hrs.csv

77102 | -1227.77611549234 | 2.2663883708821e-07 | 25.9208765645365
77112 | -1227.99519380992 | 1.83845434247223e-07 | 25.9197251811586
77122 | -1228.20155419669 | 1.42328482611195e-07 | 25.9186069783816
77132 | -1228.39452655014 | 1.0227198653274e-07 | 25.9175213037192
77142 | -1228.57355505041 | 6.38451175173701e-08 | 25.9164673318787
77152 | -1228.73819035023 | 2.71988568427457e-08 | 25.9154440955932
77162 | -1228.88813249864 | -7.53868156021037e-09 | 25.9144505012206
77172 | -1229.02323997447 | -4.02584240982066e-08 | 25.9134853209768
77182 | -1229.1435391863 | -7.0869939605185e-08 | 25.9125472351068
77192 | -1229.24923440882 | -9.93009473082383e-08 | 25.9116348544042
77202 | -1229.3407181189 | -1.25496739748387e-07 | 25.9107467037394
77212 | -1229.41858168886 | -1.49419529749509e-07 | 25.9098812477509
77222 | -1229.48362638811 | -1.71047730481785e-07 | 25.9090369498755
77232 | -1229.53684025822 | -1.9037525059514e-07 | 25.9082122467357
77242 | -1229.57939102794 | -2.07410633476842e-07 | 25.9074055415604
77252 | -1229.61266694069 | -2.2217608805789e-07 | 25.9066152644432
77262 | -1229.63829448186 | -2.34706594952797e-07 | 25.9058398649693
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
