les4675/CubeSatTimeCard/Phase Detector/TestData/ProcessedData_72hrs.csv

99105.5 | 1734.14366666667 | 2.83373333333329e-11 | 25.74698
99115.5 | 1734.42866666667 | 2.83435897435897e-11 | 25.74704
99125.5 | 1734.71366666667 | 2.83493827160488e-11 | 25.74708
99135.5 | 1734.99866666667 | 2.83547619047616e-11 | 25.74716
99145.5 | 1735.28366666667 | 2.83597701149425e-11 | 25.74718
99155.5 | 1735.56866666667 | 2.8364444444444e-11 | 25.74716
99165.5 | 1735.85366666667 | 2.83688172043009e-11 | 25.74716
99175.5 | 1736.13866666667 | 2.83729166666667e-11 | 25.74716
99185.5 | 1736.42366666667 | 2.83767676767673e-11 | 25.74718
99195.5 | 1736.70866666667 | 2.83803921568626e-11 | 25.74718
99205.5 | 1736.99366666667 | 2.8383809523809e-11 | 25.74722
99215.5 | 1737.27866666667 | 2.83870370370367e-11 | 25.74724
99225.5 | 1737.56366666667 | 2.839009009009e-11 | 25.7472
99235.5 | 1737.84866666667 | 2.83929824561399e-11 | 25.74718
99245.5 | 1738.13366666667 | 2.83957264957263e-11 | 25.74712
99255.5 | 1738.41866666667 | 2.83983333333333e-11 | 25.74708
99265.5 | 1738.70366666667 | 2.84008130081297e-11 | 25.74708
99275.5 | 1738.98866666667 | 2.84031746031744e-11 | 25.74708
99285.5 | 1739.27366666667 | 2.84054263565892e-11 | 25.74704
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
