les4675/CubeSatTimeCard/Phase Detector/TestData/ProcessedData_72hrs_ExcelFitting.csv

Time (Seconds) | Phase Error (ns) | Frequency Error (ns/ns) | Temperature (deg C) | Regression | Residual | Aging Factor (1/s) | Temperature Dependence (1/degC) | Offset
79104 | 1264.654231 | 1.46E-11 | 25.88365603 | 1.45551E-11 | 0.00E+00 | 3.472E-16 | -6E-11 | 1.46E-11
79114 | 1264.799979 | 1.46E-11 | 25.88350288 | 1.45678E-11 | -7.11E-15
79124 | 1264.945926 | 1.46E-11 | 25.88335 | 1.45804E-11 | -1.43E-14
79134 | 1265.092071 | 1.46E-11 | 25.88319738 | 1.4593E-11 | -2.14E-14
79144 | 1265.238412 | 1.46E-11 | 25.88304503 | 1.46057E-11 | -2.85E-14
79154 | 1265.384952 | 1.47E-11 | 25.88289295 | 1.46183E-11 | -3.57E-14
79164 | 1265.531688 | 1.47E-11 | 25.88274113 | 1.46308E-11 | -4.27E-14
79174 | 1265.678619 | 1.47E-11 | 25.88258958 | 1.46434E-11 | -4.98E-14
79184 | 1265.825748 | 1.47E-11 | 25.88243829 | 1.46559E-11 | -5.69E-14
79194 | 1265.973073 | 1.47E-11 | 25.88228727 | 1.46685E-11 | -6.40E-14
79204 | 1266.120593 | 1.48E-11 | 25.88213651 | 1.4681E-11 | -7.11E-14
79214 | 1266.268309 | 1.48E-11 | 25.88198602 | 1.46935E-11 | -7.81E-14
79224 | 1266.41622 | 1.48E-11 | 25.88183578 | 1.4706E-11 | -8.51E-14
79234 | 1266.564327 | 1.48E-11 | 25.88168581 | 1.47185E-11 | -9.22E-14
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
