les4675/CubeSatTimeCard/Phase Detector/TestData/ProcessedData_Fig01.jpg

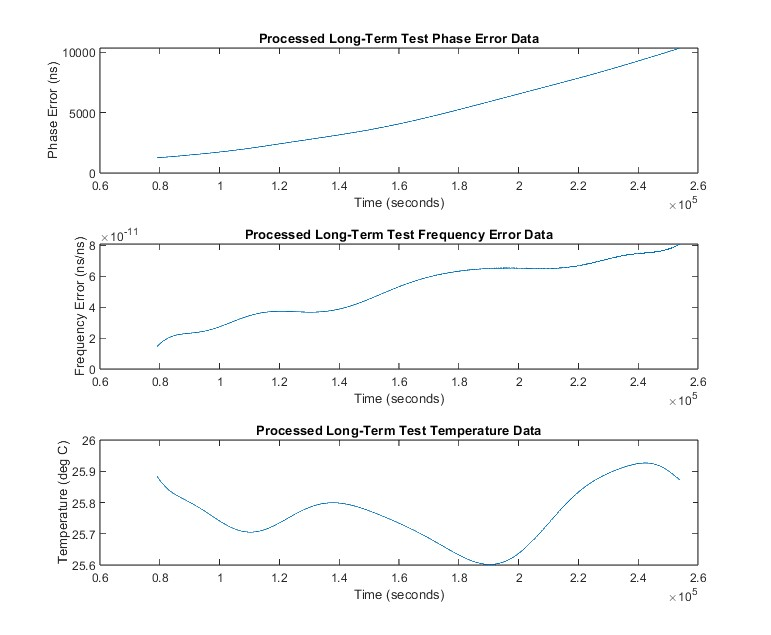
Phase Detector/TestData/ProcessedData_Fig01.jpg
