les4675/CubeSatTimeCard/Phase Detector/TestData/UnprocessedData_Fig01.jpg

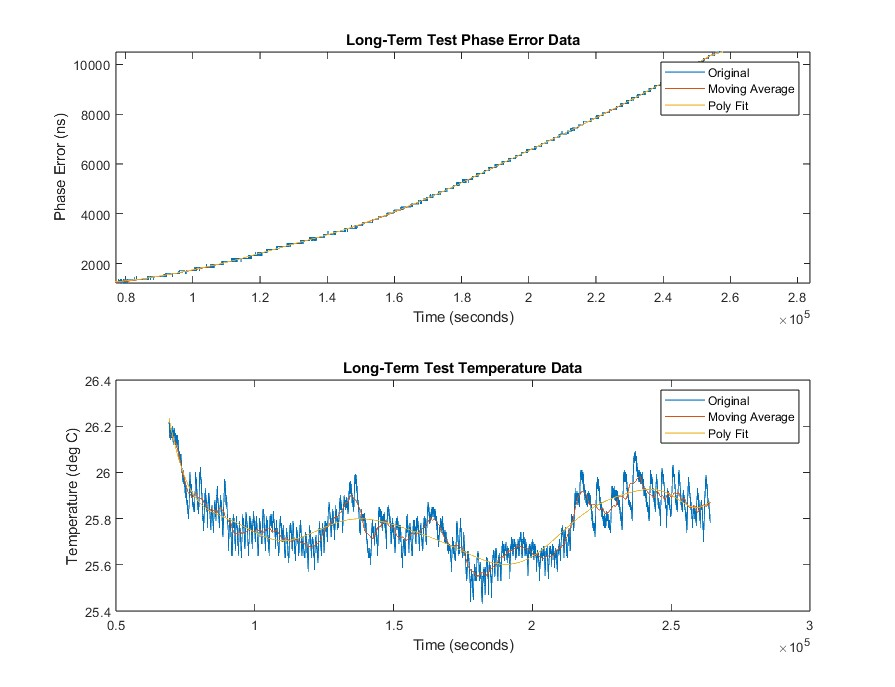
Phase Detector/TestData/UnprocessedData_Fig01.jpg
