les4675/CubeSatTimeCard/Documentation/Phase 3/Problem Tracking Template.xlsx

Sheet: Tracking Table 1
Team #: | P22257 | Team Name: | Atomic Clock
Date: | 2024-10-22 08:51 | Document Owner: | All
Revision #: | 1
Problem Number | Identifying & Selecting Problem PSP 1 | Analyzing Problem PSP 2 | Generating Potential Solutions PSP 3 | Selecting & Planning Solution PSP 4 | Implementing Solution PSP 5 | Evaluating Solution PSP 6
 | R1 | R2 | R3 | Y4 | Y5 | G6
1
2
3
4 | The car won't start. | A loose altenator belt was discovered.
5
6
7
8
9
10
 | 1 | 1 | 1 | 1 | 1 | 1
 |  |  |  | \

Sheet: Tracking Table 2 - CMO
Team #: | P22257 | Team Name: | Atomic Clock
Date: | 2024-10-22 08:51 | Document Owner: | All
Revision #: | 1
 | Identifying & Selecting Problem PSP 1 | Analyzing Problem PSP 2 | Generating Potential Solutions PSP 3 | Selecting & Planning Solution PSP 4 | Implementing Solution PSP 5 | Evaluating Solution PSP 6
Rating | R1 | R2 | R3 | Y4 | Y5 | G6
CRITICAL
 | The car won't start. | A loose altenator belt was discovered.
MAJOR
ORDINARY
 | 1 | 1 | 1 | 1 | 1 | 1
