les4675/CubeSatTimeCard/Phase Detector/TestData/ExcelCurveFitting.pdf

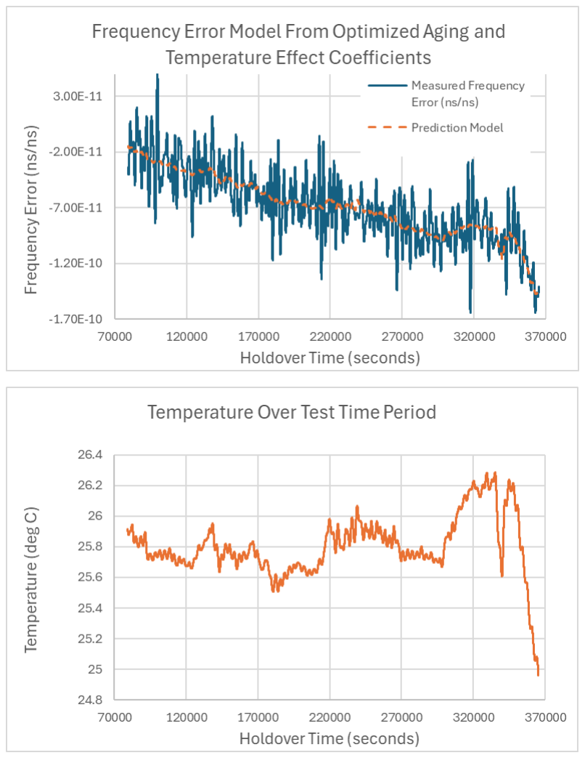
[picture p54: page 1]

## Frequency Residuals

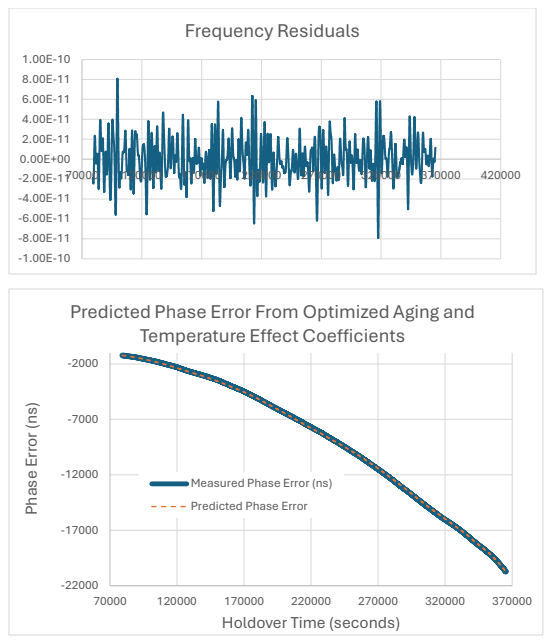
[picture p55: page 2]

Predicted Phase Error From Optimized Aging and
Temperature Effect Coefficients

Phase Error (ns)

Measured Phase Error (ns)
Predicted Phase Error

Holdover Time (seconds)
