les4675/CubeSatTimeCard/KiCAD/22257_DevBoard/22257_DevBoard/22257_DevBoard.kicad_pcb

## KiCad design KiCAD/22257_DevBoard/22257_DevBoard/22257_DevBoard.kicad_pcb (2025-03-04)

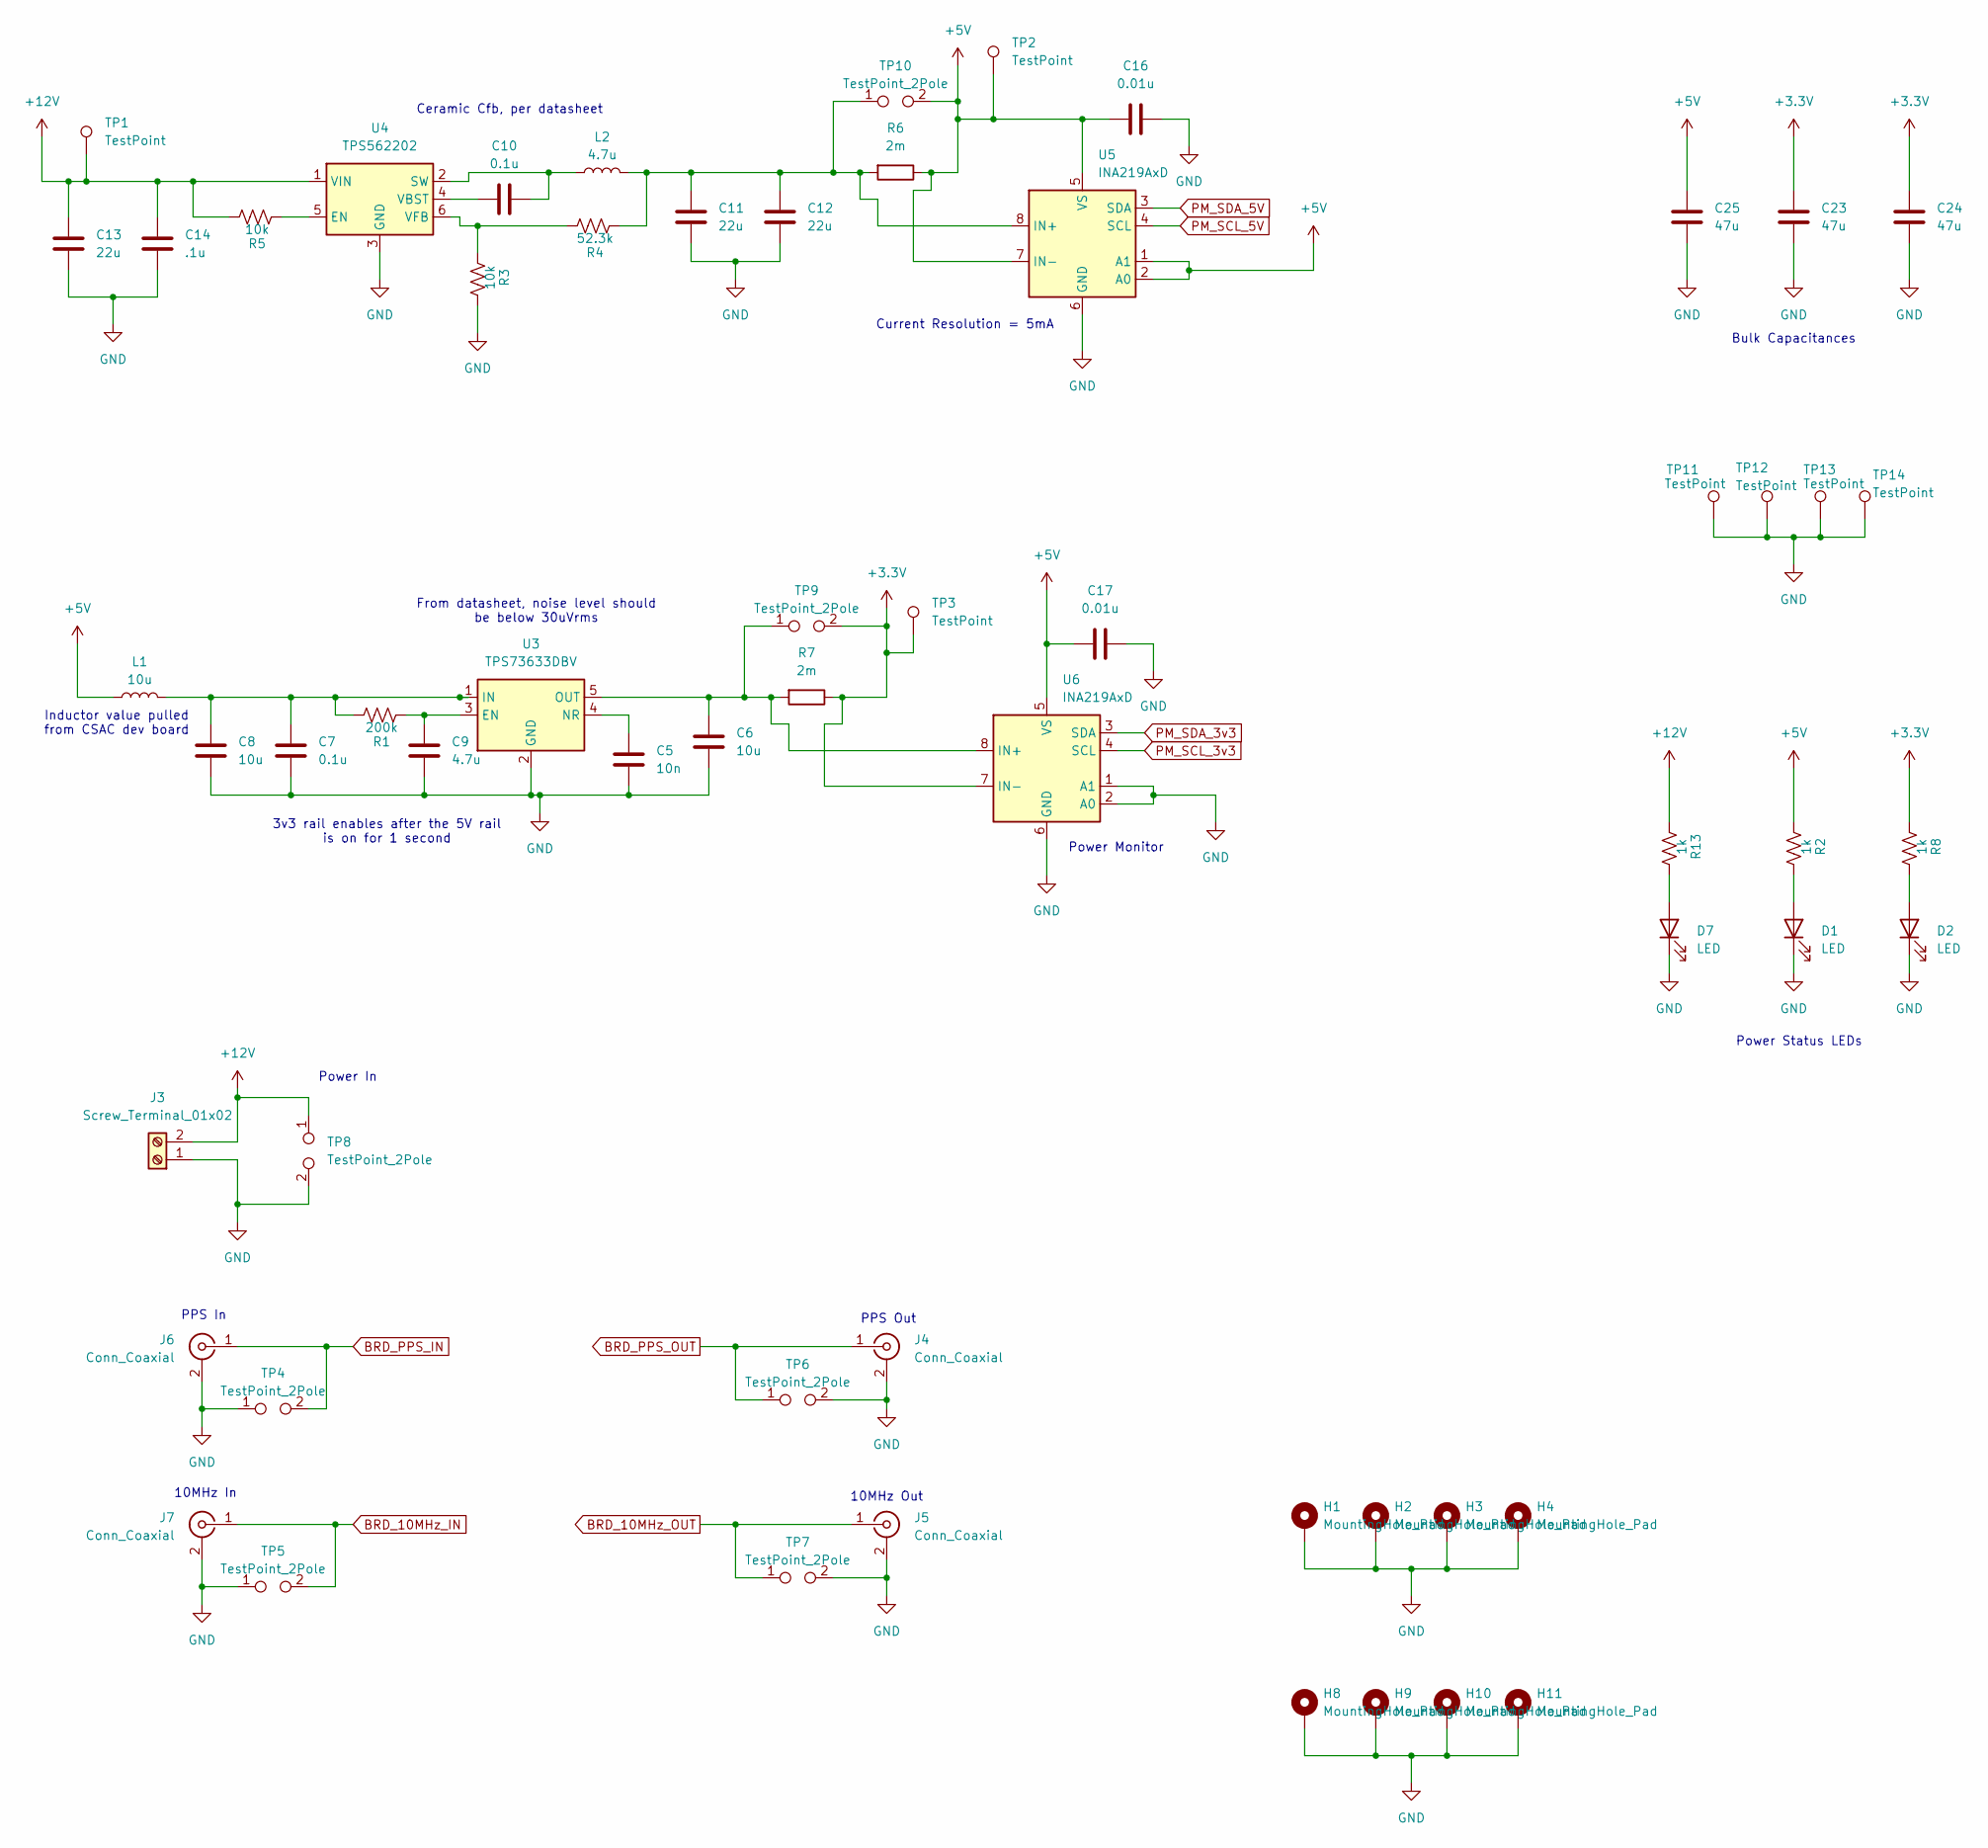
[picture p56: schematic power-connectors.kicad_sch]

Parts:
C5: 10n; C_0603_1608Metric
C6, C8: 10u; C_0603_1608Metric
C7, C10: 0.1u; C_0603_1608Metric
C9: 4.7u; C_0603_1608Metric
C11, C12, C13: 22u; C_0603_1608Metric
C14: .1u; C_0603_1608Metric
C16, C17: 0.01u; C_0603_1608Metric
C23, C24, C25: 47u; C_0603_1608Metric
D1, D2, D7: LED; LED_0603_1608Metric
H1, H2, H3, H4, H8, H9, H10, H11: MountingHole_Pad; MountingHole_3.2mm_M3_Pad
J3: Screw_Terminal_01x02; PhoenixContact_GMSTBA_2,5_2-G-7,62_1x02_P7.62mm_Horizontal
J4, J5, J6, J7: Conn_Coaxial; SMA_Amphenol_901-143_Horizontal
L1: 10u; L_Bourns-SRU8043
L2: 4.7u; L_Bourns-SRU8043
R1: 200k; R_0603_1608Metric
R2, R8, R13: 1k; R_0603_1608Metric
R3, R5: 10k; R_0603_1608Metric
R4: 52.3k; R_0603_1608Metric
R6, R7: 2m; BVT-I-R0002-1
TP1, TP2, TP3, TP11, TP12, TP13, TP14: TestPoint; TestPoint_THTPad_2.5x2.5mm_Drill1.2mm
TP4, TP5, TP6, TP7, TP8, TP9, TP10: TestPoint_2Pole; TestPoint_2Pads_Pitch5.08mm_Drill1.3mm
U3: TPS73633DBV; SOT-23-5
U4: TPS562202; SOT-563
U5, U6: INA219AxD; SOIC-8_3.9x4.9mm_P1.27mm

Connections:
+3.3V: C23.2, C24.2, R7.1, R8.2, TP3.1, TP9.2, U6.7 (IN-); also elsewhere on the board
+5V: C16.1, C17.1, C25.2, L1.1, R2.2, R6.1, TP2.1, TP10.2, U5.1 (A1), U5.2 (A0), U5.5 (VS), U5.7 (IN-), U6.5 (VS); also elsewhere on the board
+12V: C13.2, C14.2, J3.2, R5.1, R13.2, TP1.1, TP8.1, U4.1 (VIN)
BRD_10MHz_IN: J7.1 (In), TP5.2; also elsewhere on the board
BRD_10MHz_OUT: J5.1 (In), TP7.1; also elsewhere on the board
BRD_PPS_IN: J6.1 (In), TP4.2; also elsewhere on the board
BRD_PPS_OUT: J4.1 (In), TP6.1; also elsewhere on the board
GND: C5.2, C6.2, C7.2, C8.2, C9.2, C11.1, C12.1, C13.1, C14.1, C16.2, C17.2, C23.1, C24.1, C25.1, D1.1 (K), D2.1 (K), D7.1 (K), H1.1, H2.1, H3.1, H4.1, H8.1, H9.1, H10.1, H11.1, J3.1, J4.2 (Ext), J5.2 (Ext), J6.2 (Ext), J7.2 (Ext), R3.1, TP4.1, TP5.1, TP6.2, TP7.2, TP8.2, TP11.1, TP12.1, TP13.1, TP14.1, U3.2 (GND), U4.3 (GND), U5.6 (GND), U6.1 (A1), U6.2 (A0), U6.6 (GND); also elsewhere on the board
unnamed: D1.2 (A), R2.1
unnamed: D2.2 (A), R8.1
unnamed: D7.2 (A), R13.1
unnamed: C9.1, R1.2, U3.3 (EN)
unnamed: C7.1, C8.1, L1.2, R1.1, U3.1 (IN)
unnamed: C5.1, U3.4 (NR)
unnamed: C6.1, R7.2, TP9.1, U3.5 (OUT), U6.8 (IN+)
unnamed: R5.2, U4.5 (EN)
unnamed: C10.2, L2.1, U4.2 (SW)
unnamed: C10.1, U4.4 (VBST)
unnamed: R3.2, R4.1, U4.6 (VFB)
unnamed: C11.2, C12.2, L2.2, R4.2, R6.2, TP10.1, U5.8 (IN+)
PM_SCL_3v3: U6.4 (SCL); also elsewhere on the board
PM_SCL_5V: U5.4 (SCL); also elsewhere on the board
PM_SDA_3v3: U6.3 (SDA); also elsewhere on the board
PM_SDA_5V: U5.3 (SDA); also elsewhere on the board

Notes on the sheet:
10MHz Out
Power Status LEDs
3v3 rail enables after the 5V rail is on for 1 second
Power In
PPS In
Ceramic Cfb, per datasheet
From datasheet, noise level should be below 30uVrms
Current Resolution = 5mA
Power Monitor
PPS Out
Inductor value pulled from CSAC dev board
10MHz In
Bulk Capacitances

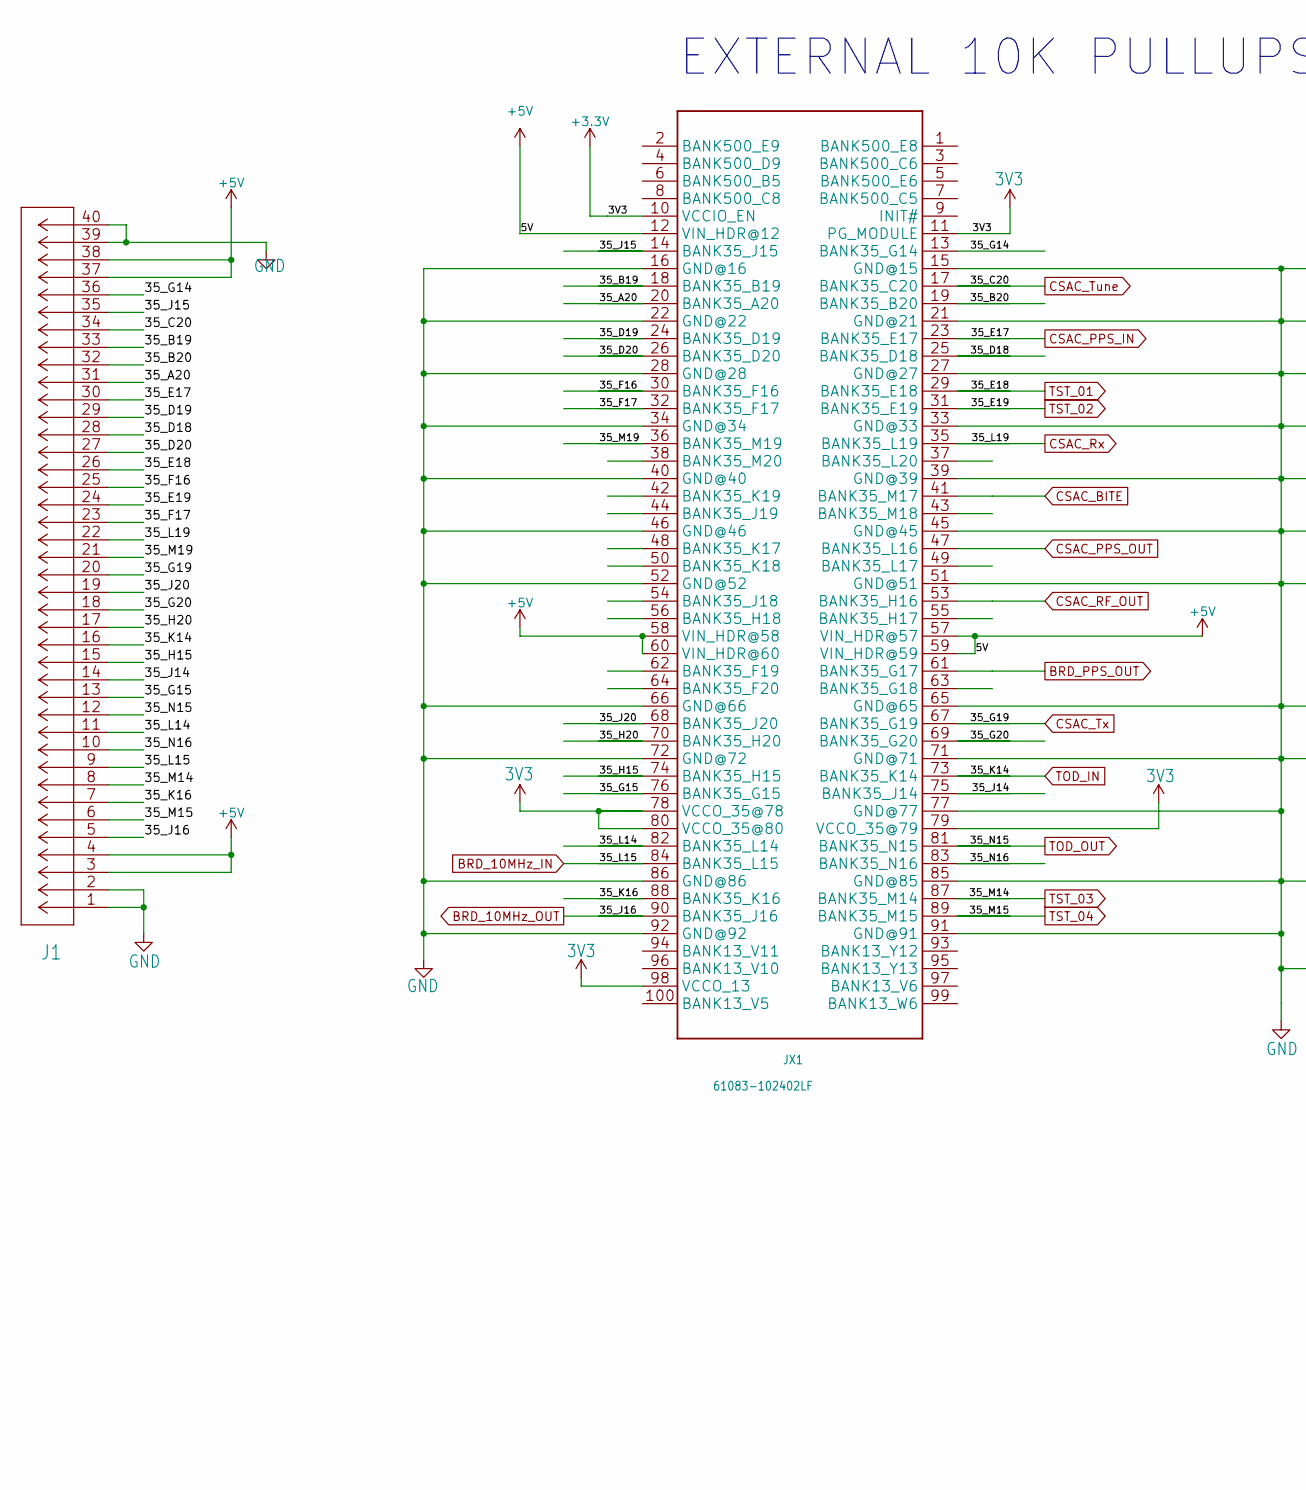
[picture p57: schematic Microzed_Headers.kicad_sch, part in row 1, column 1]

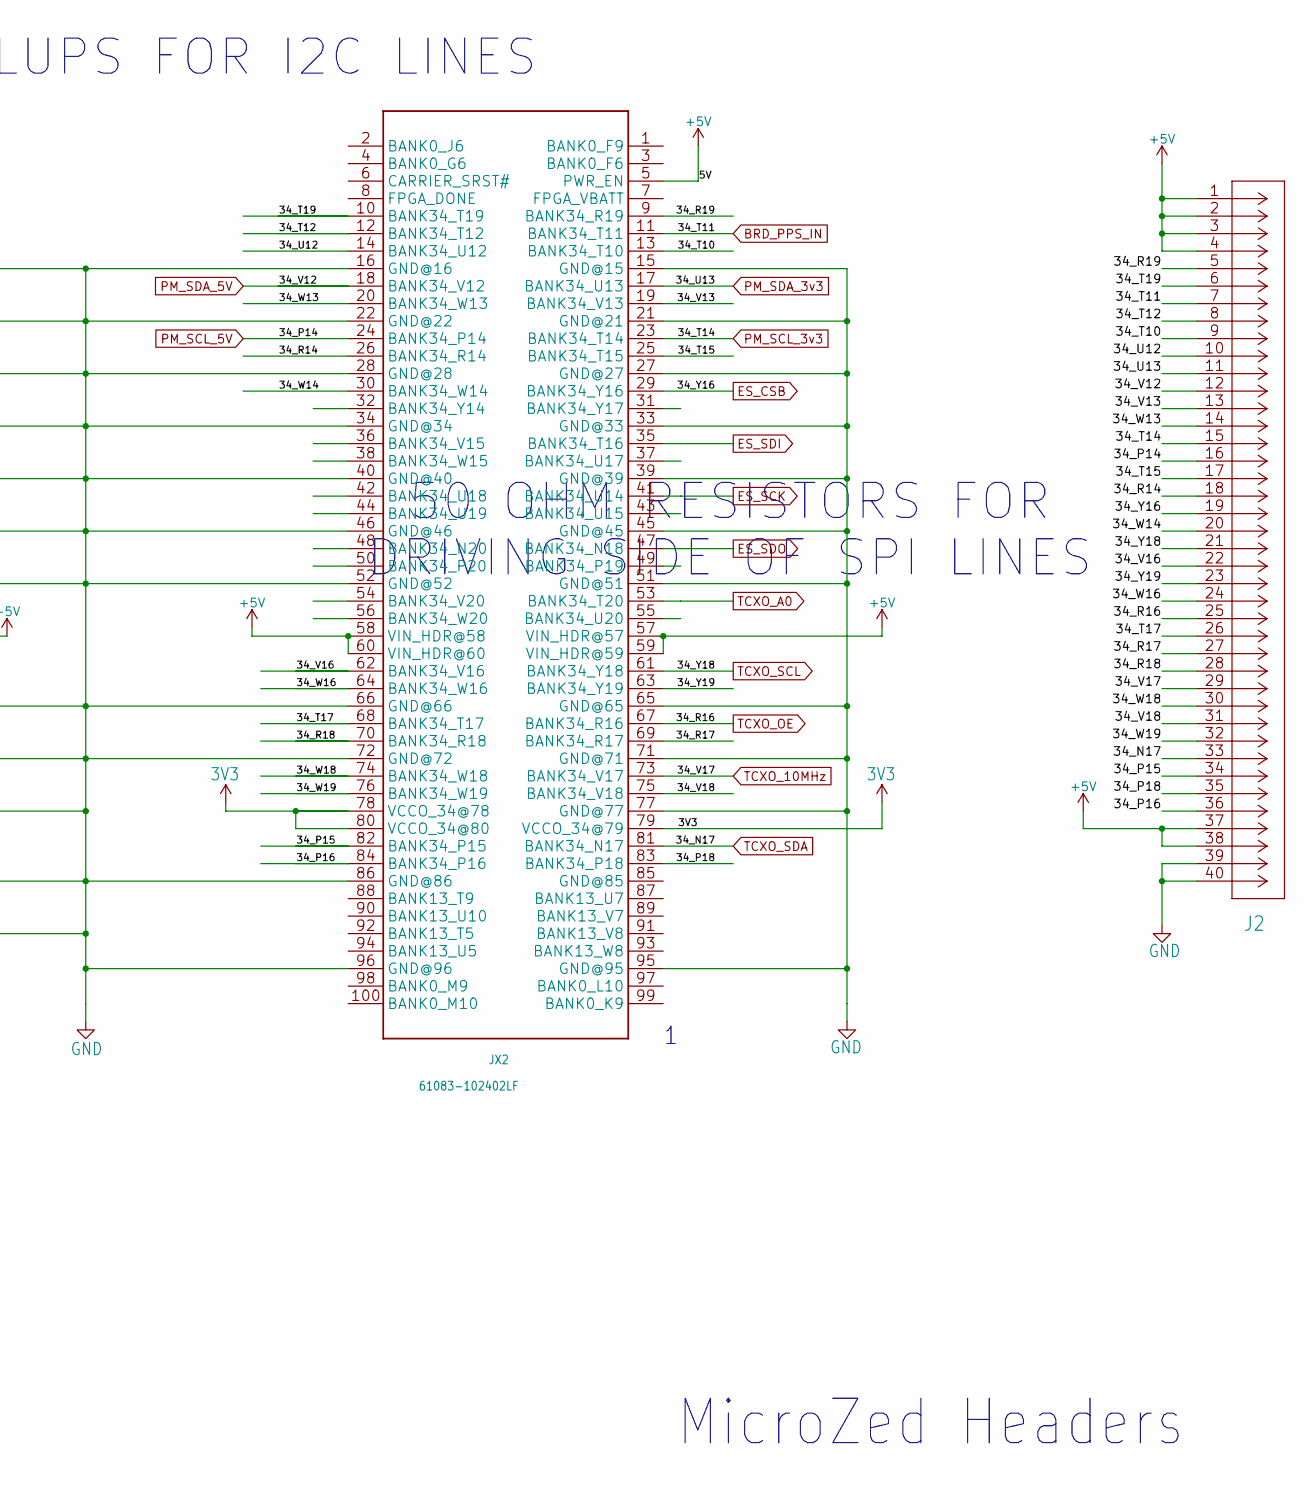
[picture p58: schematic Microzed_Headers.kicad_sch, part in row 1, column 2]

Parts:
J1, J2: TD-120-G-AACON40_2X20_TU_HTS_SAI; CON40_2X20_TU_HTS_SAI
JX1, JX2: 61083-102402LF; 61083-102402LF_1104291

Connections:
+3.3V: JX1.10 (VCCIO_EN), JX1.11 (PG_MODULE), JX1.78 (VCCO_35@78), JX1.79 (VCCO_35@79), JX1.80 (VCCO_35@80), JX1.98 (VCCO_13), JX2.78 (VCCO_34@78), JX2.79 (VCCO_34@79), JX2.80 (VCCO_34@80); also elsewhere on the board
+5V: J1.3, J1.4, J1.37, J1.38, J2.1, J2.2, J2.3, J2.4, J2.37, J2.38, JX1.12 (VIN_HDR@12), JX1.57 (VIN_HDR@57), JX1.58 (VIN_HDR@58), JX1.59 (VIN_HDR@59), JX1.60 (VIN_HDR@60), JX2.5 (PWR_EN), JX2.57 (VIN_HDR@57), JX2.58 (VIN_HDR@58), JX2.59 (VIN_HDR@59), JX2.60 (VIN_HDR@60); also elsewhere on the board
/MicroZed_Headers/34_P15: J2.34, JX2.82 (BANK34_P15)
/MicroZed_Headers/34_P16: J2.36, JX2.84 (BANK34_P16)
/MicroZed_Headers/34_P18: J2.35, JX2.83 (BANK34_P18)
/MicroZed_Headers/34_R14: J2.18, JX2.26 (BANK34_R14)
/MicroZed_Headers/34_R17: J2.27, JX2.69 (BANK34_R17)
/MicroZed_Headers/34_R18: J2.28, JX2.70 (BANK34_R18)
/MicroZed_Headers/34_R19: J2.5, JX2.9 (BANK34_R19)
/MicroZed_Headers/34_T10: J2.9, JX2.13 (BANK34_T10)
/MicroZed_Headers/34_T12: J2.8, JX2.12 (BANK34_T12)
/MicroZed_Headers/34_T15: J2.17, JX2.25 (BANK34_T15)
/MicroZed_Headers/34_T17: J2.26, JX2.68 (BANK34_T17)
/MicroZed_Headers/34_T19: J2.6, JX2.10 (BANK34_T19)
/MicroZed_Headers/34_U12: J2.10, JX2.14 (BANK34_U12)
/MicroZed_Headers/34_V13: J2.13, JX2.19 (BANK34_V13)
/MicroZed_Headers/34_V16: J2.22, JX2.62 (BANK34_V16)
/MicroZed_Headers/34_V18: J2.31, JX2.75 (BANK34_V18)
/MicroZed_Headers/34_W13: J2.14, JX2.20 (BANK34_W13)
/MicroZed_Headers/34_W14: J2.20, JX2.30 (BANK34_W14)
/MicroZed_Headers/34_W16: J2.24, JX2.64 (BANK34_W16)
/MicroZed_Headers/34_W18: J2.30, JX2.74 (BANK34_W18)
/MicroZed_Headers/34_W19: J2.32, JX2.76 (BANK34_W19)
/MicroZed_Headers/34_Y19: J2.23, JX2.63 (BANK34_Y19)
/MicroZed_Headers/35_A20: J1.31, JX1.20 (BANK35_A20)
/MicroZed_Headers/35_B19: J1.33, JX1.18 (BANK35_B19)
/MicroZed_Headers/35_B20: J1.32, JX1.19 (BANK35_B20)
/MicroZed_Headers/35_D18: J1.28, JX1.25 (BANK35_D18)
/MicroZed_Headers/35_D19: J1.29, JX1.24 (BANK35_D19)
/MicroZed_Headers/35_D20: J1.27, JX1.26 (BANK35_D20)
/MicroZed_Headers/35_F16: J1.25, JX1.30 (BANK35_F16)
/MicroZed_Headers/35_F17: J1.23, JX1.32 (BANK35_F17)
/MicroZed_Headers/35_G14: J1.36, JX1.13 (BANK35_G14)
/MicroZed_Headers/35_G15: J1.13, JX1.76 (BANK35_G15)
/MicroZed_Headers/35_G20: J1.18, JX1.69 (BANK35_G20)
/MicroZed_Headers/35_H15: J1.15, JX1.74 (BANK35_H15)
/MicroZed_Headers/35_H20: J1.17, JX1.70 (BANK35_H20)
/MicroZed_Headers/35_J14: J1.14, JX1.75 (BANK35_J14)
/MicroZed_Headers/35_J15: J1.35, JX1.14 (BANK35_J15)
/MicroZed_Headers/35_J20: J1.19, JX1.68 (BANK35_J20)
/MicroZed_Headers/35_K16: J1.7, JX1.88 (BANK35_K16)
/MicroZed_Headers/35_L14: J1.11, JX1.82 (BANK35_L14)
/MicroZed_Headers/35_M19: J1.21, JX1.36 (BANK35_M19)
/MicroZed_Headers/35_N16: J1.10, JX1.83 (BANK35_N16)
BRD_10MHz_IN: J1.9, JX1.84 (BANK35_L15); also elsewhere on the board
BRD_10MHz_OUT: J1.5, JX1.90 (BANK35_J16); also elsewhere on the board
BRD_PPS_IN: J2.7, JX2.11 (BANK34_T11); also elsewhere on the board
BRD_PPS_OUT: JX1.61 (BANK35_G17); also elsewhere on the board
CSAC_BITE: JX1.41 (BANK35_M17); also elsewhere on the board
CSAC_PPS_IN: J1.30, JX1.23 (BANK35_E17); also elsewhere on the board
CSAC_PPS_OUT: JX1.47 (BANK35_L16); also elsewhere on the board
CSAC_RF_OUT: JX1.53 (BANK35_H16); also elsewhere on the board
CSAC_Rx: J1.22, JX1.35 (BANK35_L19); also elsewhere on the board
CSAC_Tune: J1.34, JX1.17 (BANK35_C20); also elsewhere on the board
CSAC_Tx: J1.20, JX1.67 (BANK35_G19); also elsewhere on the board
ES_CSB: J2.19, JX2.29 (BANK34_Y16); also elsewhere on the board
ES_SCK: JX2.41 (BANK34_U14); also elsewhere on the board
ES_SDI: JX2.35 (BANK34_T16); also elsewhere on the board
ES_SDO: JX2.47 (BANK34_N18)
GND: J1.1, J1.2, J1.39, J1.40, J2.39, J2.40, JX1.15 (GND@15), JX1.16 (GND@16), JX1.21 (GND@21), JX1.22 (GND@22), JX1.27 (GND@27), JX1.28 (GND@28), JX1.33 (GND@33), JX1.34 (GND@34), JX1.39 (GND@39), JX1.40 (GND@40), JX1.45 (GND@45), JX1.46 (GND@46), JX1.51 (GND@51), JX1.52 (GND@52), JX1.65 (GND@65), JX1.66 (GND@66), JX1.71 (GND@71), JX1.72 (GND@72), JX1.77 (GND@77), JX1.85 (GND@85), JX1.86 (GND@86), JX1.91 (GND@91), JX1.92 (GND@92), JX2.15 (GND@15), JX2.16 (GND@16), JX2.21 (GND@21), JX2.22 (GND@22), JX2.27 (GND@27), JX2.28 (GND@28), JX2.33 (GND@33), JX2.34 (GND@34), JX2.39 (GND@39), JX2.40 (GND@40), JX2.45 (GND@45), JX2.46 (GND@46), JX2.51 (GND@51), JX2.52 (GND@52), JX2.65 (GND@65), JX2.66 (GND@66), JX2.71 (GND@71), JX2.72 (GND@72), JX2.77 (GND@77), JX2.86 (GND@86), JX2.95 (GND@95), JX2.96 (GND@96); also elsewhere on the board
PM_SCL_3v3: J2.15, JX2.23 (BANK34_T14); also elsewhere on the board
PM_SCL_5V: J2.16, JX2.24 (BANK34_P14); also elsewhere on the board
PM_SDA_3v3: J2.11, JX2.17 (BANK34_U13); also elsewhere on the board
PM_SDA_5V: J2.12, JX2.18 (BANK34_V12); also elsewhere on the board
TCXO_10MHz: J2.29, JX2.73 (BANK34_V17); also elsewhere on the board
TCXO_A0: JX2.53 (BANK34_T20)
TCXO_OE: J2.25, JX2.67 (BANK34_R16); also elsewhere on the board
TCXO_SCL: J2.21, JX2.61 (BANK34_Y18); also elsewhere on the board
TCXO_SDA: J2.33, JX2.81 (BANK34_N17); also elsewhere on the board
TOD_IN: J1.16, JX1.73 (BANK35_K14)
TOD_OUT: J1.12, JX1.81 (BANK35_N15)
TST_01: J1.26, JX1.29 (BANK35_E18); also elsewhere on the board
TST_02: J1.24, JX1.31 (BANK35_E19); also elsewhere on the board
TST_03: J1.8, JX1.87 (BANK35_M14); also elsewhere on the board
TST_04: J1.6, JX1.89 (BANK35_M15); also elsewhere on the board

Notes on the sheet:
EXTERNAL 10K PULLUPS FOR I2C LINES
MicroZed Headers
50 OHM RESISTORS FOR DRIVING SIDE OF SPI LINES

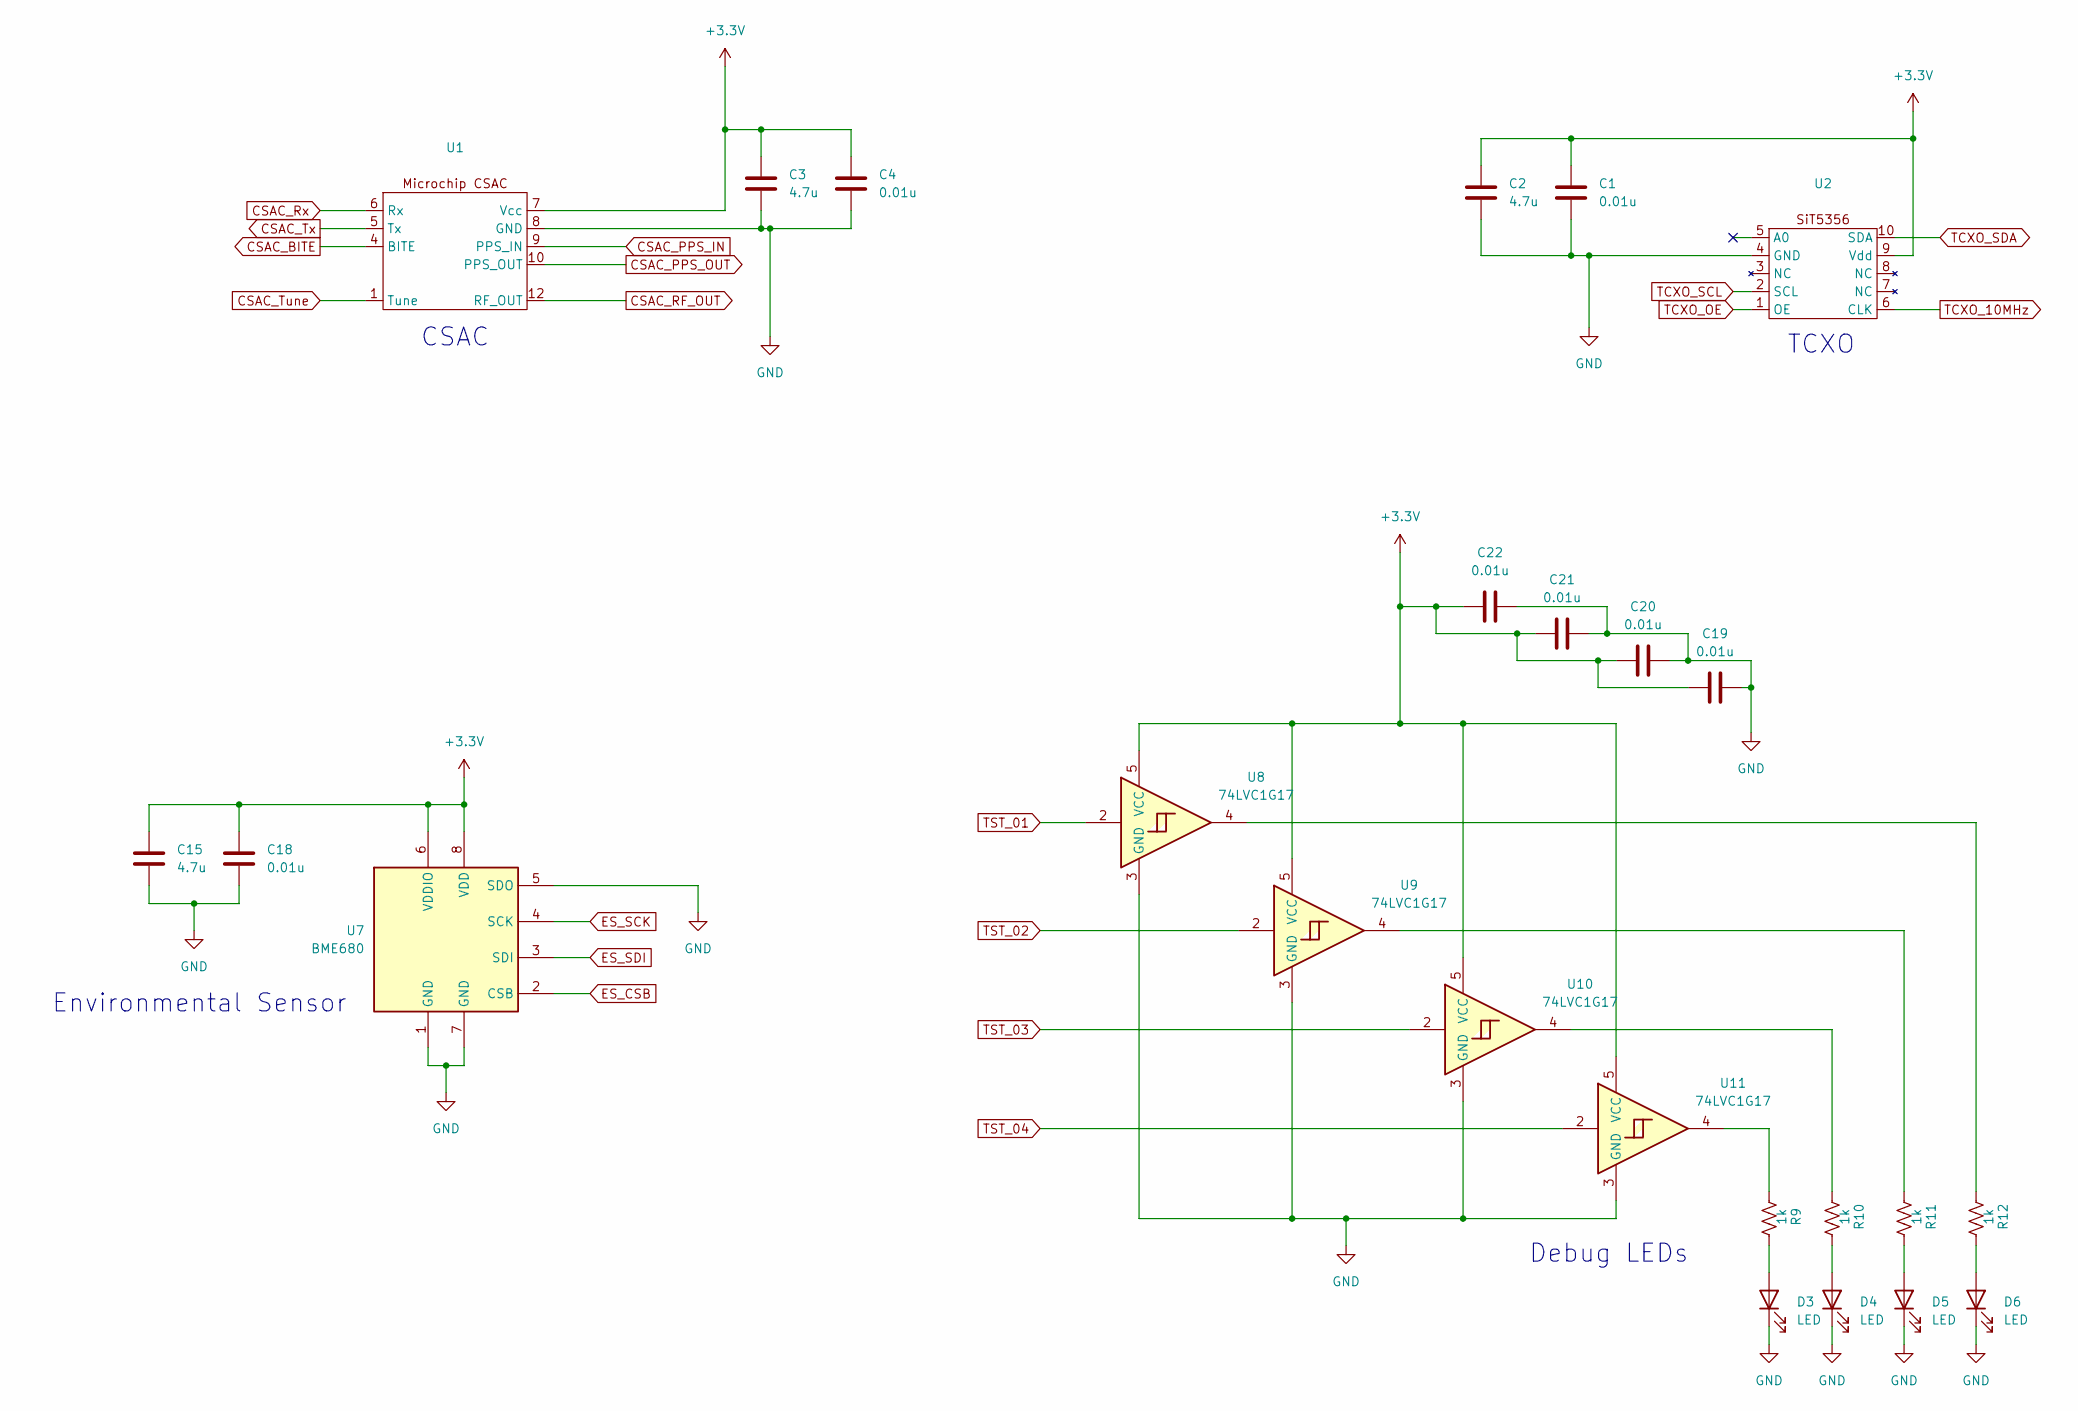
[picture p59: schematic oscillators.kicad_sch]

Parts:
C1, C4, C18, C19, C20, C21, C22: 0.01u; C_0603_1608Metric
C2, C3, C15: 4.7u; C_0603_1608Metric
D3, D4, D5, D6: LED; LED_0603_1608Metric
R9, R10, R11, R12: 1k; R_0603_1608Metric
U1: SA-45
U2: SiT5356
U7: BME680; Bosch_LGA-8_3x3mm_P0.8mm_ClockwisePinNumbering
U8, U9, U10, U11: 74LVC1G17; SOT-23-5_HandSoldering

Connections:
+3.3V: C1.1, C2.1, C3.1, C4.1, C15.1, C18.1, C19.1, C20.1, C21.1, C22.1, U1.7 (Vcc), U2.9 (Vdd), U7.6 (VDDIO), U7.8 (VDD), U8.5 (VCC), U9.5 (VCC), U10.5 (VCC), U11.5 (VCC); also elsewhere on the board
CSAC_BITE: U1.4 (BITE); also elsewhere on the board
CSAC_PPS_IN: U1.9 (PPS_IN); also elsewhere on the board
CSAC_PPS_OUT: U1.10 (PPS_OUT); also elsewhere on the board
CSAC_RF_OUT: U1.12 (RF_OUT); also elsewhere on the board
CSAC_Rx: U1.6 (Rx); also elsewhere on the board
CSAC_Tune: U1.1 (Tune); also elsewhere on the board
CSAC_Tx: U1.5 (Tx); also elsewhere on the board
ES_CSB: U7.2 (CSB); also elsewhere on the board
ES_SCK: U7.4 (SCK); also elsewhere on the board
ES_SDI: U7.3 (SDI); also elsewhere on the board
GND: C1.2, C2.2, C3.2, C4.2, C15.2, C18.2, C19.2, C20.2, C21.2, C22.2, D3.1 (K), D4.1 (K), D5.1 (K), D6.1 (K), U1.8 (GND), U2.4 (GND), U7.1 (GND), U7.5 (SDO), U7.7 (GND), U8.3 (GND), U9.3 (GND), U10.3 (GND), U11.3 (GND); also elsewhere on the board
unnamed: D3.2 (A), R9.1
unnamed: D4.2 (A), R10.1
unnamed: D5.2 (A), R11.1
unnamed: D6.2 (A), R12.1
unnamed: R9.2, U11.4
unnamed: R10.2, U10.4
unnamed: R11.2, U9.4
unnamed: R12.2, U8.4
TCXO_10MHz: U2.6 (CLK); also elsewhere on the board
TCXO_OE: U2.1 (OE); also elsewhere on the board
TCXO_SCL: U2.2 (SCL); also elsewhere on the board
TCXO_SDA: U2.10 (SDA); also elsewhere on the board
TST_01: U8.2; also elsewhere on the board
TST_02: U9.2; also elsewhere on the board
TST_03: U10.2; also elsewhere on the board
TST_04: U11.2; also elsewhere on the board

Notes on the sheet:
Environmental Sensor
Debug LEDs
TCXO
CSAC

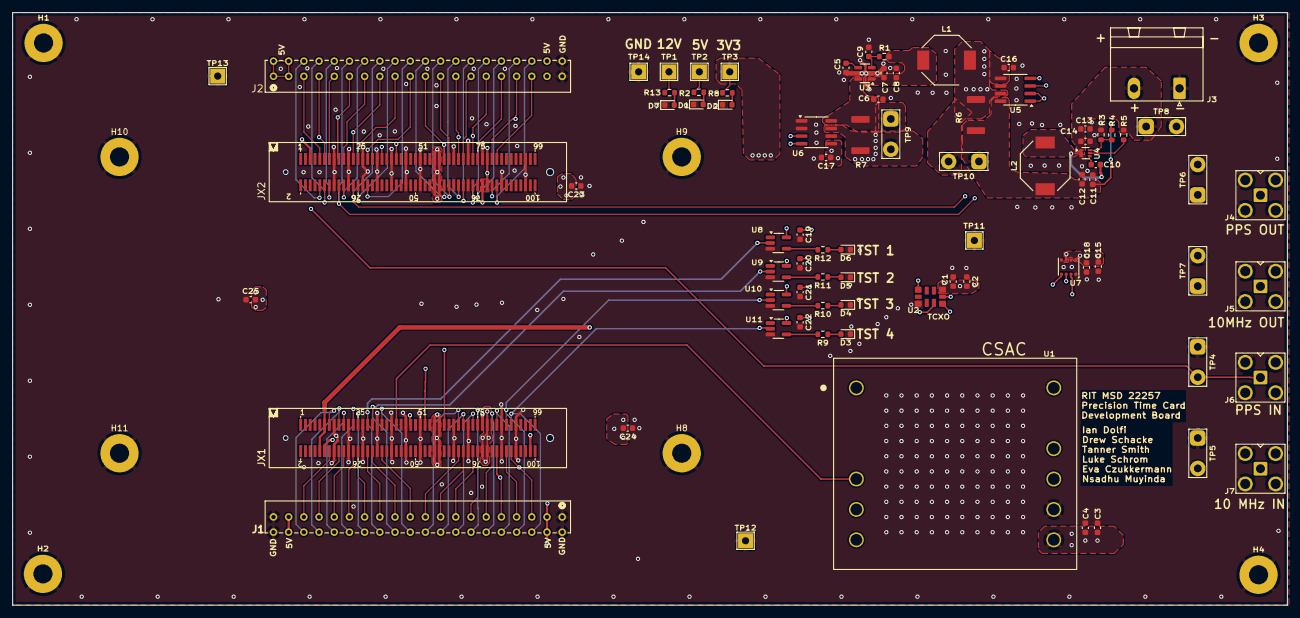
[picture p60: board 22257_DevBoard.kicad_pcb from above]

Board: 6 copper layers, 213.1 x 99.1 mm, 89 parts (0 on the bottom side), 94 nets.
