les4675/CubeSatTimeCard/KiCAD/Reimport/ZED_BREAKOUT v32.kicad_pcb

## KiCad design KiCAD/Reimport/ZED_BREAKOUT v32.kicad_pcb (2025-03-04)

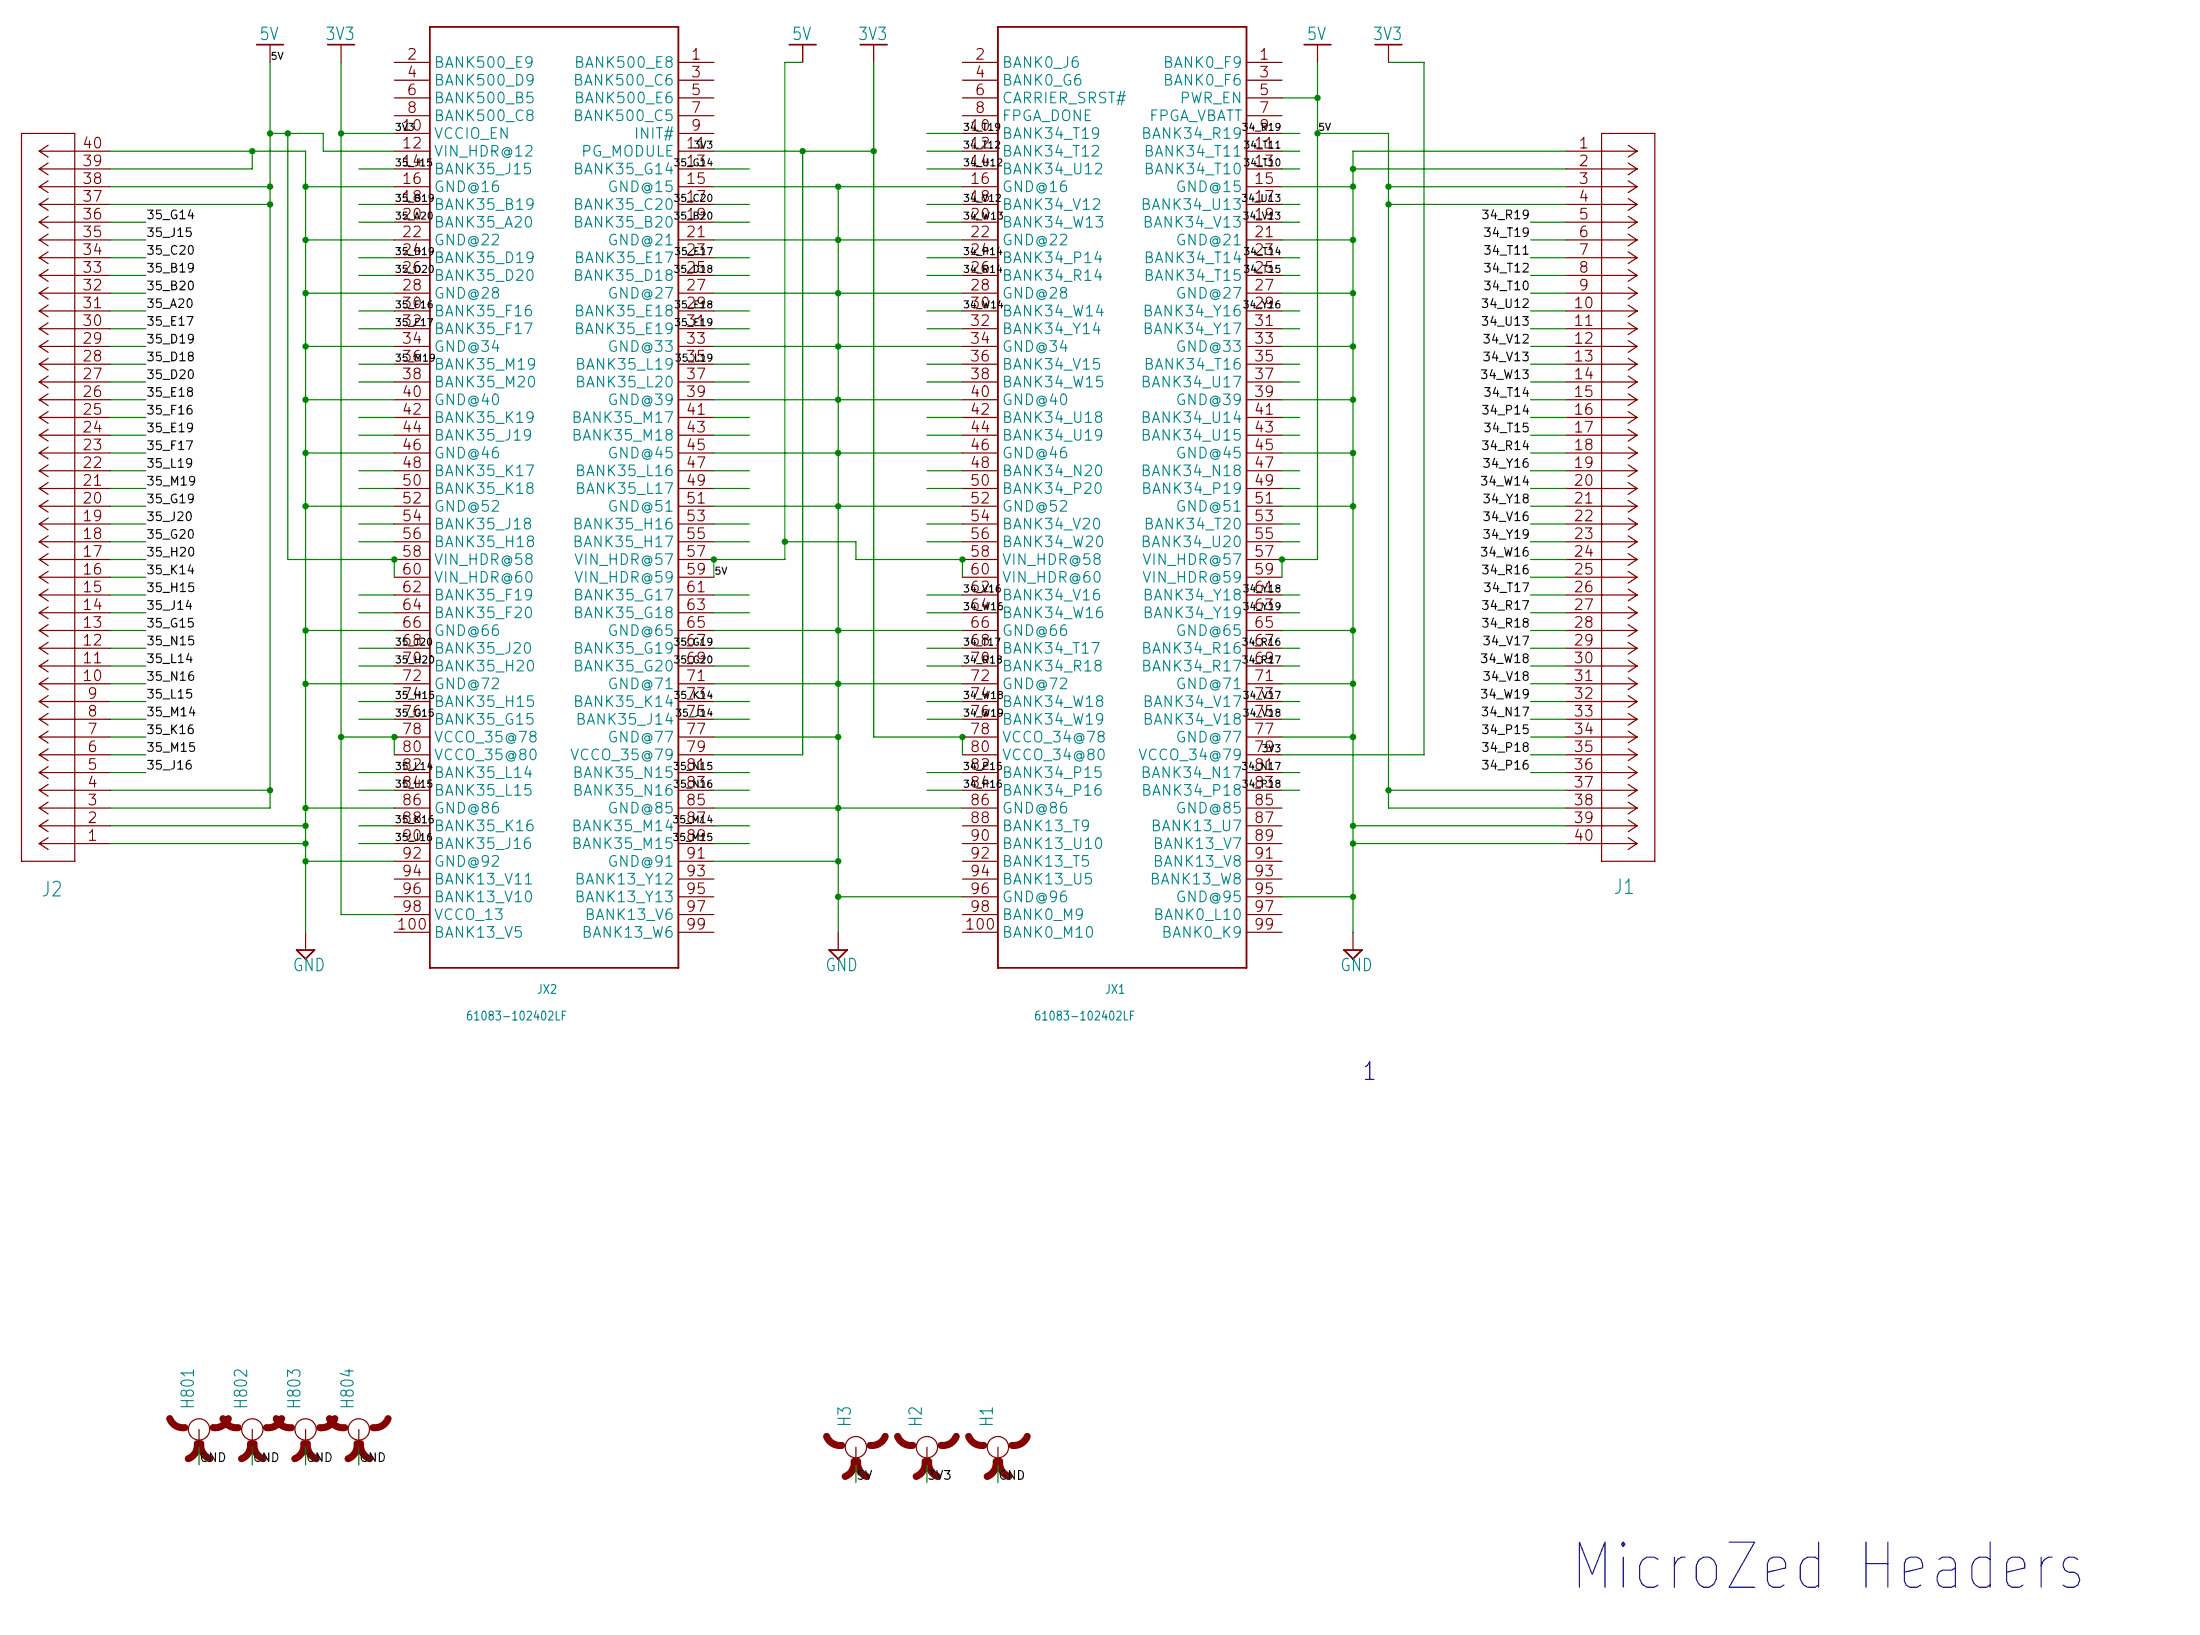
[picture p61: schematic MicroZed_Headers.kicad_sch, MicroZed Headers]

Parts:
H1, H2, H3, H801, H802, H803, H804: MOUNT-PAD-ROUND5.0; 5,0-PAD
J1, J2: TD-120-G-AACON40_2X20_TU_HTS_SAI; CON40_2X20_TU_HTS_SAI
JX1, JX2: 61083-102402LF

Connections:
3V3: H2.B5, JX1.78 (VCCO_34@78), JX1.79 (VCCO_34@79), JX1.80 (VCCO_34@80), JX2.10 (VCCIO_EN), JX2.11 (PG_MODULE), JX2.78 (VCCO_35@78), JX2.79 (VCCO_35@79), JX2.80 (VCCO_35@80), JX2.98 (VCCO_13)
5V: H3.B5, J1.3, J1.4, J1.37, J1.38, J2.3, J2.4, J2.37, J2.38, JX1.5 (PWR_EN), JX1.57 (VIN_HDR@57), JX1.58 (VIN_HDR@58), JX1.59 (VIN_HDR@59), JX1.60 (VIN_HDR@60), JX2.12 (VIN_HDR@12), JX2.57 (VIN_HDR@57), JX2.58 (VIN_HDR@58), JX2.59 (VIN_HDR@59), JX2.60 (VIN_HDR@60)
34_N17: J1.33, JX1.81 (BANK34_N17)
34_N18: JX1.47 (BANK34_N18)
34_N20: JX1.48 (BANK34_N20)
34_P14: J1.16, JX1.24 (BANK34_P14)
34_P15: J1.34, JX1.82 (BANK34_P15)
34_P16: J1.36, JX1.84 (BANK34_P16)
34_P18: J1.35, JX1.83 (BANK34_P18)
34_P19: JX1.49 (BANK34_P19)
34_P20: JX1.50 (BANK34_P20)
34_R14: J1.18, JX1.26 (BANK34_R14)
34_R16: J1.25, JX1.67 (BANK34_R16)
34_R17: J1.27, JX1.69 (BANK34_R17)
34_R18: J1.28, JX1.70 (BANK34_R18)
34_R19: J1.5, JX1.9 (BANK34_R19)
34_T10: J1.9, JX1.13 (BANK34_T10)
34_T11: J1.7, JX1.11 (BANK34_T11)
34_T12: J1.8, JX1.12 (BANK34_T12)
34_T14: J1.15, JX1.23 (BANK34_T14)
34_T15: J1.17, JX1.25 (BANK34_T15)
34_T16: JX1.35 (BANK34_T16)
34_T17: J1.26, JX1.68 (BANK34_T17)
34_T19: J1.6, JX1.10 (BANK34_T19)
34_T20: JX1.53 (BANK34_T20)
34_U12: J1.10, JX1.14 (BANK34_U12)
34_U13: J1.11, JX1.17 (BANK34_U13)
34_U14: JX1.41 (BANK34_U14)
34_U15: JX1.43 (BANK34_U15)
34_U17: JX1.37 (BANK34_U17)
34_U18: JX1.42 (BANK34_U18)
34_U19: JX1.44 (BANK34_U19)
34_U20: JX1.55 (BANK34_U20)
34_V12: J1.12, JX1.18 (BANK34_V12)
34_V13: J1.13, JX1.19 (BANK34_V13)
34_V15: JX1.36 (BANK34_V15)
34_V16: J1.22, JX1.62 (BANK34_V16)
34_V17: J1.29, JX1.73 (BANK34_V17)
34_V18: J1.31, JX1.75 (BANK34_V18)
34_V20: JX1.54 (BANK34_V20)
34_W13: J1.14, JX1.20 (BANK34_W13)
34_W14: J1.20, JX1.30 (BANK34_W14)
34_W15: JX1.38 (BANK34_W15)
34_W16: J1.24, JX1.64 (BANK34_W16)
34_W18: J1.30, JX1.74 (BANK34_W18)
34_W19: J1.32, JX1.76 (BANK34_W19)
34_W20: JX1.56 (BANK34_W20)
34_Y14: JX1.32 (BANK34_Y14)
34_Y16: J1.19, JX1.29 (BANK34_Y16)
34_Y17: JX1.31 (BANK34_Y17)
34_Y18: J1.21, JX1.61 (BANK34_Y18)
34_Y19: J1.23, JX1.63 (BANK34_Y19)
35_A20: J2.31, JX2.20 (BANK35_A20)
35_B19: J2.33, JX2.18 (BANK35_B19)
35_B20: J2.32, JX2.19 (BANK35_B20)
35_C20: J2.34, JX2.17 (BANK35_C20)
35_D18: J2.28, JX2.25 (BANK35_D18)
35_D19: J2.29, JX2.24 (BANK35_D19)
35_D20: J2.27, JX2.26 (BANK35_D20)
35_E17: J2.30, JX2.23 (BANK35_E17)
35_E18: J2.26, JX2.29 (BANK35_E18)
35_E19: J2.24, JX2.31 (BANK35_E19)
35_F16: J2.25, JX2.30 (BANK35_F16)
35_F17: J2.23, JX2.32 (BANK35_F17)
35_F19: JX2.62 (BANK35_F19)
35_F20: JX2.64 (BANK35_F20)
35_G14: J2.36, JX2.13 (BANK35_G14)
35_G15: J2.13, JX2.76 (BANK35_G15)
35_G17: JX2.61 (BANK35_G17)
35_G18: JX2.63 (BANK35_G18)
35_G19: J2.20, JX2.67 (BANK35_G19)
35_G20: J2.18, JX2.69 (BANK35_G20)
35_H15: J2.15, JX2.74 (BANK35_H15)
35_H16: JX2.53 (BANK35_H16)
35_H17: JX2.55 (BANK35_H17)
35_H18: JX2.56 (BANK35_H18)
35_H20: J2.17, JX2.70 (BANK35_H20)
35_J14: J2.14, JX2.75 (BANK35_J14)
35_J15: J2.35, JX2.14 (BANK35_J15)
35_J16: J2.5, JX2.90 (BANK35_J16)
35_J18: JX2.54 (BANK35_J18)
35_J19: JX2.44 (BANK35_J19)
35_J20: J2.19, JX2.68 (BANK35_J20)
35_K14: J2.16, JX2.73 (BANK35_K14)
35_K16: J2.7, JX2.88 (BANK35_K16)
35_K17: JX2.48 (BANK35_K17)
35_K18: JX2.50 (BANK35_K18)
35_K19: JX2.42 (BANK35_K19)
35_L14: J2.11, JX2.82 (BANK35_L14)
35_L15: J2.9, JX2.84 (BANK35_L15)
35_L16: JX2.47 (BANK35_L16)
35_L17: JX2.49 (BANK35_L17)
35_L19: J2.22, JX2.35 (BANK35_L19)
35_L20: JX2.37 (BANK35_L20)
35_M14: J2.8, JX2.87 (BANK35_M14)
35_M15: J2.6, JX2.89 (BANK35_M15)
35_M17: JX2.41 (BANK35_M17)
35_M18: JX2.43 (BANK35_M18)
35_M19: J2.21, JX2.36 (BANK35_M19)
35_M20: JX2.38 (BANK35_M20)
35_N15: J2.12, JX2.81 (BANK35_N15)
35_N16: J2.10, JX2.83 (BANK35_N16)
GND: H1.B5, H801.B5, H802.B5, H803.B5, H804.B5, J1.1, J1.2, J1.39, J1.40, J2.1, J2.2, J2.39, J2.40, JX1.15 (GND@15), JX1.16 (GND@16), JX1.21 (GND@21), JX1.22 (GND@22), JX1.27 (GND@27), JX1.28 (GND@28), JX1.33 (GND@33), JX1.34 (GND@34), JX1.39 (GND@39), JX1.40 (GND@40), JX1.45 (GND@45), JX1.46 (GND@46), JX1.51 (GND@51), JX1.52 (GND@52), JX1.65 (GND@65), JX1.66 (GND@66), JX1.71 (GND@71), JX1.72 (GND@72), JX1.77 (GND@77), JX1.86 (GND@86), JX1.95 (GND@95), JX1.96 (GND@96), JX2.15 (GND@15), JX2.16 (GND@16), JX2.21 (GND@21), JX2.22 (GND@22), JX2.27 (GND@27), JX2.28 (GND@28), JX2.33 (GND@33), JX2.34 (GND@34), JX2.39 (GND@39), JX2.40 (GND@40), JX2.45 (GND@45), JX2.46 (GND@46), JX2.51 (GND@51), JX2.52 (GND@52), JX2.65 (GND@65), JX2.66 (GND@66), JX2.71 (GND@71), JX2.72 (GND@72), JX2.77 (GND@77), JX2.85 (GND@85), JX2.86 (GND@86), JX2.91 (GND@91), JX2.92 (GND@92)

Notes on the sheet:
MicroZed Headers


Parts:
H1, H2, H3, H801, H802, H803, H804: MOUNT-PAD-ROUND5.0; 5,0-PAD
J1, J2: TD-120-G-AACON40_2X20_TU_HTS_SAI; CON40_2X20_TU_HTS_SAI
JX1, JX2: 61083-102402LF

Connections:
3V3: H2.B5, JX1.78 (VCCO_34@78), JX1.79 (VCCO_34@79), JX1.80 (VCCO_34@80), JX2.10 (VCCIO_EN), JX2.11 (PG_MODULE), JX2.78 (VCCO_35@78), JX2.79 (VCCO_35@79), JX2.80 (VCCO_35@80), JX2.98 (VCCO_13)
5V: H3.B5, J1.3, J1.4, J1.37, J1.38, J2.3, J2.4, J2.37, J2.38, JX1.5 (PWR_EN), JX1.57 (VIN_HDR@57), JX1.58 (VIN_HDR@58), JX1.59 (VIN_HDR@59), JX1.60 (VIN_HDR@60), JX2.12 (VIN_HDR@12), JX2.57 (VIN_HDR@57), JX2.58 (VIN_HDR@58), JX2.59 (VIN_HDR@59), JX2.60 (VIN_HDR@60)
34_N17: J1.33, JX1.81 (BANK34_N17)
34_N18: JX1.47 (BANK34_N18)
34_N20: JX1.48 (BANK34_N20)
34_P14: J1.16, JX1.24 (BANK34_P14)
34_P15: J1.34, JX1.82 (BANK34_P15)
34_P16: J1.36, JX1.84 (BANK34_P16)
34_P18: J1.35, JX1.83 (BANK34_P18)
34_P19: JX1.49 (BANK34_P19)
34_P20: JX1.50 (BANK34_P20)
34_R14: J1.18, JX1.26 (BANK34_R14)
34_R16: J1.25, JX1.67 (BANK34_R16)
34_R17: J1.27, JX1.69 (BANK34_R17)
34_R18: J1.28, JX1.70 (BANK34_R18)
34_R19: J1.5, JX1.9 (BANK34_R19)
34_T10: J1.9, JX1.13 (BANK34_T10)
34_T11: J1.7, JX1.11 (BANK34_T11)
34_T12: J1.8, JX1.12 (BANK34_T12)
34_T14: J1.15, JX1.23 (BANK34_T14)
34_T15: J1.17, JX1.25 (BANK34_T15)
34_T16: JX1.35 (BANK34_T16)
34_T17: J1.26, JX1.68 (BANK34_T17)
34_T19: J1.6, JX1.10 (BANK34_T19)
34_T20: JX1.53 (BANK34_T20)
34_U12: J1.10, JX1.14 (BANK34_U12)
34_U13: J1.11, JX1.17 (BANK34_U13)
34_U14: JX1.41 (BANK34_U14)
34_U15: JX1.43 (BANK34_U15)
34_U17: JX1.37 (BANK34_U17)
34_U18: JX1.42 (BANK34_U18)
34_U19: JX1.44 (BANK34_U19)
34_U20: JX1.55 (BANK34_U20)
34_V12: J1.12, JX1.18 (BANK34_V12)
34_V13: J1.13, JX1.19 (BANK34_V13)
34_V15: JX1.36 (BANK34_V15)
34_V16: J1.22, JX1.62 (BANK34_V16)
34_V17: J1.29, JX1.73 (BANK34_V17)
34_V18: J1.31, JX1.75 (BANK34_V18)
34_V20: JX1.54 (BANK34_V20)
34_W13: J1.14, JX1.20 (BANK34_W13)
34_W14: J1.20, JX1.30 (BANK34_W14)
34_W15: JX1.38 (BANK34_W15)
34_W16: J1.24, JX1.64 (BANK34_W16)
34_W18: J1.30, JX1.74 (BANK34_W18)
34_W19: J1.32, JX1.76 (BANK34_W19)
34_W20: JX1.56 (BANK34_W20)
34_Y14: JX1.32 (BANK34_Y14)
34_Y16: J1.19, JX1.29 (BANK34_Y16)
34_Y17: JX1.31 (BANK34_Y17)
34_Y18: J1.21, JX1.61 (BANK34_Y18)
34_Y19: J1.23, JX1.63 (BANK34_Y19)
35_A20: J2.31, JX2.20 (BANK35_A20)
35_B19: J2.33, JX2.18 (BANK35_B19)
35_B20: J2.32, JX2.19 (BANK35_B20)
35_C20: J2.34, JX2.17 (BANK35_C20)
35_D18: J2.28, JX2.25 (BANK35_D18)
35_D19: J2.29, JX2.24 (BANK35_D19)
35_D20: J2.27, JX2.26 (BANK35_D20)
35_E17: J2.30, JX2.23 (BANK35_E17)
35_E18: J2.26, JX2.29 (BANK35_E18)
35_E19: J2.24, JX2.31 (BANK35_E19)
35_F16: J2.25, JX2.30 (BANK35_F16)
35_F17: J2.23, JX2.32 (BANK35_F17)
35_F19: JX2.62 (BANK35_F19)
35_F20: JX2.64 (BANK35_F20)
35_G14: J2.36, JX2.13 (BANK35_G14)
35_G15: J2.13, JX2.76 (BANK35_G15)
35_G17: JX2.61 (BANK35_G17)
35_G18: JX2.63 (BANK35_G18)
35_G19: J2.20, JX2.67 (BANK35_G19)
35_G20: J2.18, JX2.69 (BANK35_G20)
35_H15: J2.15, JX2.74 (BANK35_H15)
35_H16: JX2.53 (BANK35_H16)
35_H17: JX2.55 (BANK35_H17)
35_H18: JX2.56 (BANK35_H18)
35_H20: J2.17, JX2.70 (BANK35_H20)
35_J14: J2.14, JX2.75 (BANK35_J14)
35_J15: J2.35, JX2.14 (BANK35_J15)
35_J16: J2.5, JX2.90 (BANK35_J16)
35_J18: JX2.54 (BANK35_J18)
35_J19: JX2.44 (BANK35_J19)
35_J20: J2.19, JX2.68 (BANK35_J20)
35_K14: J2.16, JX2.73 (BANK35_K14)
35_K16: J2.7, JX2.88 (BANK35_K16)
35_K17: JX2.48 (BANK35_K17)
35_K18: JX2.50 (BANK35_K18)
35_K19: JX2.42 (BANK35_K19)
35_L14: J2.11, JX2.82 (BANK35_L14)
35_L15: J2.9, JX2.84 (BANK35_L15)
35_L16: JX2.47 (BANK35_L16)
35_L17: JX2.49 (BANK35_L17)
35_L19: J2.22, JX2.35 (BANK35_L19)
35_L20: JX2.37 (BANK35_L20)
35_M14: J2.8, JX2.87 (BANK35_M14)
35_M15: J2.6, JX2.89 (BANK35_M15)
35_M17: JX2.41 (BANK35_M17)
35_M18: JX2.43 (BANK35_M18)
35_M19: J2.21, JX2.36 (BANK35_M19)
35_M20: JX2.38 (BANK35_M20)
35_N15: J2.12, JX2.81 (BANK35_N15)
35_N16: J2.10, JX2.83 (BANK35_N16)
GND: H1.B5, H801.B5, H802.B5, H803.B5, H804.B5, J1.1, J1.2, J1.39, J1.40, J2.1, J2.2, J2.39, J2.40, JX1.15 (GND@15), JX1.16 (GND@16), JX1.21 (GND@21), JX1.22 (GND@22), JX1.27 (GND@27), JX1.28 (GND@28), JX1.33 (GND@33), JX1.34 (GND@34), JX1.39 (GND@39), JX1.40 (GND@40), JX1.45 (GND@45), JX1.46 (GND@46), JX1.51 (GND@51), JX1.52 (GND@52), JX1.65 (GND@65), JX1.66 (GND@66), JX1.71 (GND@71), JX1.72 (GND@72), JX1.77 (GND@77), JX1.86 (GND@86), JX1.95 (GND@95), JX1.96 (GND@96), JX2.15 (GND@15), JX2.16 (GND@16), JX2.21 (GND@21), JX2.22 (GND@22), JX2.27 (GND@27), JX2.28 (GND@28), JX2.33 (GND@33), JX2.34 (GND@34), JX2.39 (GND@39), JX2.40 (GND@40), JX2.45 (GND@45), JX2.46 (GND@46), JX2.51 (GND@51), JX2.52 (GND@52), JX2.65 (GND@65), JX2.66 (GND@66), JX2.71 (GND@71), JX2.72 (GND@72), JX2.77 (GND@77), JX2.85 (GND@85), JX2.86 (GND@86), JX2.91 (GND@91), JX2.92 (GND@92)

Notes on the sheet:
MicroZed Headers

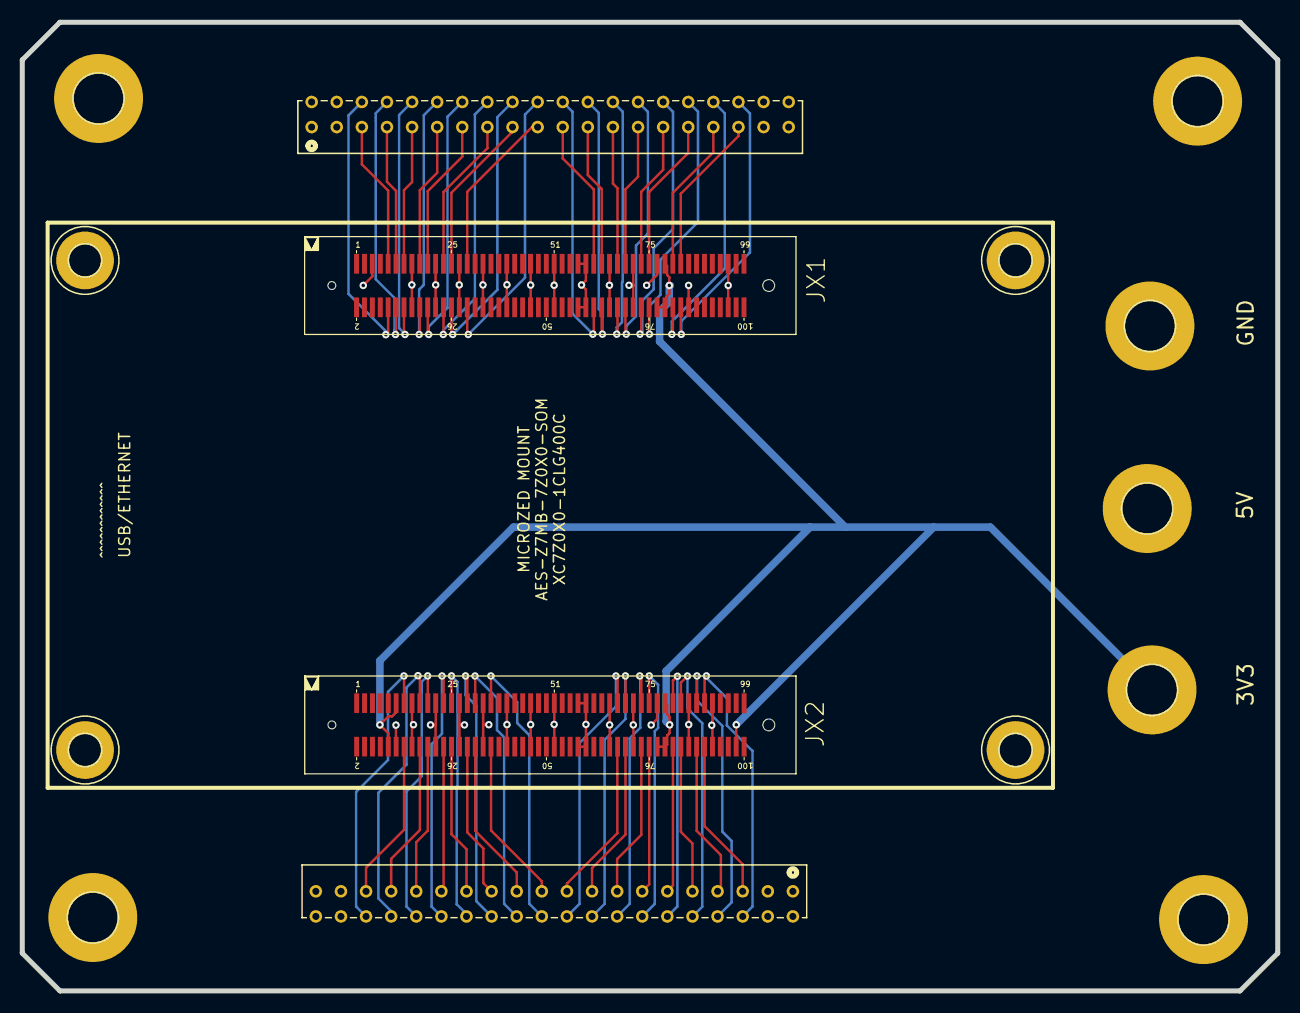
[picture p62: board ZED_BREAKOUT v32.kicad_pcb from above]

Board: 2 copper layers, 127.0 x 98.0 mm, 15 parts (0 on the bottom side), 67 nets.

Other parts of the board:
E$1, E$2, E$3, E$4: 3,2-PAD
