les4675/CubeSatTimeCard/space_time_card/.wsdata/.peers.ini

DefaultTarget=true
ServiceManagerID=2db65eb3-3c18-4dfd-a46b-7ee9f712f389
TransportName=TCP
AutoSetJtagFrequency=false
PeerTypeId=LINUX_EMULATION
UserName=dds5098
Port=1440
Host=127.0.0.1
OSName=Windows 10
ID=LinuxEmulation
AgentID=2db65eb3-3c18-4dfd-a46b-7ee9f712f389
Name=LinuxEmulation

DefaultTarget=true
ServiceManagerID=2db65eb3-3c18-4dfd-a46b-7ee9f712f389
TransportName=TCP
AutoSetJtagFrequency=false
PeerTypeId=XRT_SERVER
UserName=dds5098
Port=1222
Host=127.0.0.1
OSName=Windows 10
ID=XRTServer
AgentID=2db65eb3-3c18-4dfd-a46b-7ee9f712f389
Name=XRTServer

DefaultTarget=true
ServiceManagerID=2db65eb3-3c18-4dfd-a46b-7ee9f712f389
TransportName=TCP
AutoSetJtagFrequency=true
PeerTypeId=HARDWARE_SERVER
UserName=dds5098
Port=3121
Host=127.0.0.1
OSName=Windows 10
ID=Local
AgentID=2db65eb3-3c18-4dfd-a46b-7ee9f712f389
Name=Local

DefaultTarget=true
ServiceManagerID=2db65eb3-3c18-4dfd-a46b-7ee9f712f389
TransportName=TCP
AutoSetJtagFrequency=false
PeerTypeId=LINUX_TCF_AGENT
UserName=dds5098
Port=1534
Host=192.168.0.1
OSName=Windows 10
ID=Linux Agent
AgentID=2db65eb3-3c18-4dfd-a46b-7ee9f712f389
Name=Linux Agent

DefaultTarget=true
ServiceManagerID=2db65eb3-3c18-4dfd-a46b-7ee9f712f389
TransportName=TCP
AutoSetJtagFrequency=false
PeerTypeId=QEMU_TCF_GDB_CLIENT
UserName=dds5098
Port=1138
Host=127.0.0.1
OSName=Windows 10
ID=QEMU
AgentID=2db65eb3-3c18-4dfd-a46b-7ee9f712f389
Name=QEMU
