les4675/CubeSatTimeCard/C functions/bme688_xilinx_i2c.c

#include <stdio.h>
#include "xiicps.h"  // Xilinx PS I2C library
#include "xparameters.h"  // Hardware parameters
#include "BME688.h"

#define BME688_I2C_ADDR  0x76  // Default I2C address

XIicPs IicInstance;

int BME688_Init();
int BME688_ReadData(uint8_t reg, uint8_t *data, int length);
int BME688_WriteData(uint8_t reg, uint8_t data);
float BME688_GetTemperature();
float BME688_GetHumidity();
float BME688_GetPressure();
float BME688_GetGasResistance();

int BME688_Init() {
    int Status;
    XIicPs_Config *Config;
    Config = XIicPs_LookupConfig(XPAR_XIICPS_0_DEVICE_ID);
    if (Config == NULL) {
        return XST_FAILURE;
    }
    Status = XIicPs_CfgInitialize(&IicInstance, Config, Config->BaseAddress);
    if (Status != XST_SUCCESS) {
        return XST_FAILURE;
    }
    XIicPs_SetSClk(&IicInstance, 100000);
    return XST_SUCCESS;
}

int BME688_ReadData(uint8_t reg, uint8_t *data, int length) {
    if (XIicPs_MasterSendPolled(&IicInstance, &reg, 1, BME688_I2C_ADDR) != XST_SUCCESS) {
        return XST_FAILURE;
    }
    while (XIicPs_BusIsBusy(&IicInstance));
    if (XIicPs_MasterRecvPolled(&IicInstance, data, length, BME688_I2C_ADDR) != XST_SUCCESS) {
        return XST_FAILURE;
    }
    while (XIicPs_BusIsBusy(&IicInstance));
    return XST_SUCCESS;
}

int BME688_WriteData(uint8_t reg, uint8_t data) {
    uint8_t buffer[2] = {reg, data};
    if (XIicPs_MasterSendPolled(&IicInstance, buffer, 2, BME688_I2C_ADDR) != XST_SUCCESS) {
        return XST_FAILURE;
    }
    while (XIicPs_BusIsBusy(&IicInstance));
    return XST_SUCCESS;
}

float BME688_GetTemperature() {
    uint8_t temp_data[3];
    if (BME688_ReadData(0x22, temp_data, 3) != XST_SUCCESS) {
        return -1.0f;
    }
    int32_t adc_T = (temp_data[0] << 12) | (temp_data[1] << 4) | (temp_data[2] >> 4);
    return (adc_T / 100.0f);  // Placeholder conversion
}

float BME688_GetHumidity() {
    uint8_t hum_data[2];
    if (BME688_ReadData(0x25, hum_data, 2) != XST_SUCCESS) {
        return -1.0f;
    }
    int32_t adc_H = (hum_data[0] << 8) | hum_data[1];
    return (adc_H / 1024.0f) * 100.0f;  // Placeholder conversion
}

float BME688_GetPressure() {
    uint8_t press_data[3];
    if (BME688_ReadData(0x1F, press_data, 3) != XST_SUCCESS) {
        return -1.0f;
    }
    int32_t adc_P = (press_data[0] << 12) | (press_data[1] << 4) | (press_data[2] >> 4);
    return (adc_P / 100.0f);  // Placeholder conversion
}

float BME688_GetGasResistance() {
    uint8_t gas_data[2];
    if (BME688_ReadData(0x2A, gas_data, 2) != XST_SUCCESS) {
        return -1.0f;
    }
    int32_t adc_G = (gas_data[0] << 2) | (gas_data[1] >> 6);
    return (adc_G * 10.0f);  // Placeholder conversion
}
