les4675/CubeSatTimeCard/(commit log)

2024-11-26 Added temperature profile for sattilite in orbit
2024-11-29 SHould actually save temperature model addition
2025-01-06 Documentation update
    [Customer_Engineering Requirements.xlsx, Problem Tracking Template.xlsx, Pugh Chart.xlsx]
2025-01-28 Implemented PID Filter simulation. Read annotations.
2025-02-06 BME688 I2C Driver
2025-02-06 Drivers :)
2025-02-06 Added a matlab script that will help me determing the power spectrum of oscillator noise
2025-02-11 Obtained transfer function for oscillator noise power spectrum due to allan deviation related effects
2025-02-25 Added KiCAD Files
    [22257 v10.brd, 22257 v8.sch, 22257_DevBoard.kicad_pcb, 22257_DevBoard.kicad_sch, 22257_DevBoard_HighLevel.kicad_sch, MicroZed_Headers.kicad_sch, Microzed_Headers.kicad_sch, ZED_BREAKOUT v32.brd]
2025-02-26 Schematic Progress. Added connections to the MicroZed and added a 3v3 rail regulator
    [22257_DevBoard.kicad_sch, Microzed_Headers.kicad_sch, oscillators.kicad_sch, power-connectors.kicad_sch]
2025-02-27 More Schematic Updates
    Added power monitors and connectors, along with finishing the power circuitry.
    [22257_DevBoard.kicad_sch, Microzed_Headers.kicad_sch, oscillators.kicad_sch, power-connectors.kicad_sch]
2025-02-27 Schematic should be finished, onto layout
    [22257_DevBoard.kicad_sch, Microzed_Headers.kicad_sch, oscillators.kicad_sch, power-connectors.kicad_sch]
2025-02-27 Assignmed Most footprints. Created footprints for oscillators.
    [22257_DevBoard.kicad_pcb, 22257_DevBoard.kicad_sch, Microzed_Headers.kicad_sch, oscillators.kicad_sch, power-connectors.kicad_sch]
2025-02-28 Started layout
    [22257_DevBoard.kicad_pcb, 22257_DevBoard.kicad_sch, Microzed_Headers.kicad_sch, ZED_BREAKOUT v32.kicad_pcb, oscillators.kicad_sch, power-connectors.kicad_sch]
2025-03-01 Finished Component Placement and Arrangement.
    [22257_DevBoard.kicad_pcb, 22257_DevBoard.kicad_sch, Microzed_Headers.kicad_sch, power-connectors.kicad_sch]
2025-03-01 Routed Breakouts
    [22257_DevBoard.kicad_pcb]
2025-03-01 A lot of routing progress done
    [22257_DevBoard.kicad_pcb, Microzed_Headers.kicad_sch]
2025-03-03 Power Pours
    [22257_DevBoard.kicad_pcb, power-connectors.kicad_sch]
2025-03-03 EOD
    Nearly finished routing
    [22257_DevBoard.kicad_pcb, Microzed_Headers.kicad_sch, power-connectors.kicad_sch]
2025-03-04 Routing progress
    [22257_DevBoard.kicad_pcb]
2025-03-04 DONE ROUTINGgit add .git add .
    [22257_DevBoard.kicad_pcb, 22257_DevBoard.kicad_sch, Microzed_Headers.kicad_sch, power-connectors.kicad_sch]
2025-03-04 Done with routing-related DRCs!!
    [22257_DevBoard.kicad_pcb]
2025-03-04 Almost done silkscreening :,)
    [22257_DevBoard.kicad_pcb]
2025-03-04 NO DRC ERRORS!!!!
    Fuck I'm tired
2025-03-04 Done :D
    Existence is pain
    [22257_DevBoard.kicad_pcb, 22257_DevBoard.kicad_sch, power-connectors.kicad_sch]
2025-03-04 Added notes from review with Carlos
    [22257_DevBoard.kicad_pcb, 22257_DevBoard.kicad_sch, Microzed_Headers.kicad_sch, oscillators.kicad_sch, power-connectors.kicad_sch]
2025-03-04 Started BOM
    [22257_DevBoard.kicad_pcb, 22257_DevBoard.kicad_sch, 22257_DevBoard_BOM.csv, 22257_DevBoard_BOM.xlsx, Microzed_Headers.kicad_sch, oscillators.kicad_sch, power-connectors.kicad_sch]
2025-03-04 Part numbers added to BOM
    the .xlsx file
    [22257_DevBoard_BOM.xlsx]
2025-03-05 Finished Edits
    Edits from design review are done, and the BOM has part numbers filled out
    [22257_DevBoard.kicad_sch, 22257_DevBoard_BOM.xlsx, Microzed_Headers.kicad_sch]
2025-03-06 Output Files Generated
    [22257_DevBoard-B_Cu.gbr, 22257_DevBoard-B_Mask.gbr, 22257_DevBoard-Edge_Cuts.gbr, 22257_DevBoard-F_Cu.gbr, 22257_DevBoard-F_Mask.gbr, 22257_DevBoard-F_Paste.gbr, 22257_DevBoard-F_Silkscreen.gbr, 22257_DevBoard-In1-GND_Cu.gbr]
2025-03-11 Currently Logging Data
2025-03-14 Processed Some Data
    From the 72hr dataset
    [ProcessedData_72hrs.csv]
2025-03-14 Started Excel Curve Fitting
    [ProcessedData_72hrs_ExcelFitting.csv]
2025-03-15 Compiled Data
    From 104 Hour Test
    [ProcessedData_72hrs.csv, ProcessedData_72hrs_ExcelFitting.xlsx]
2025-03-16 Done data processing for now
    [ProcessedData_105hrs.csv]
2025-03-18 Added Simulink data processing method
    [ProcessedData_105hrs.csv]
