les4675/CubeSatTimeCard/(notices)

Notices in the files:
parts and their libraries:
2024-11-13_22-37-46_Library: COPYRIGHT: Copyright (C) 2024 Ultra Librarian. All rights reserved.
